SweatyOffenburg/Servo/HardwareMotorcontrollerV1.2/README.md

# Servo
Publication of Sweaty's servo Hardware describede 12th Workshop on Humanoid Soccer Robots IEEE RAS International Conference on Humanoid Robots — November 15-17, 2017, Birmingham (UK)
  /
