SweatyOffenburg/Servo/HardwareMotorcontrollerV1.2/Servo2015_Logic_V1.2.brd.pdf

2.2u150R
100n

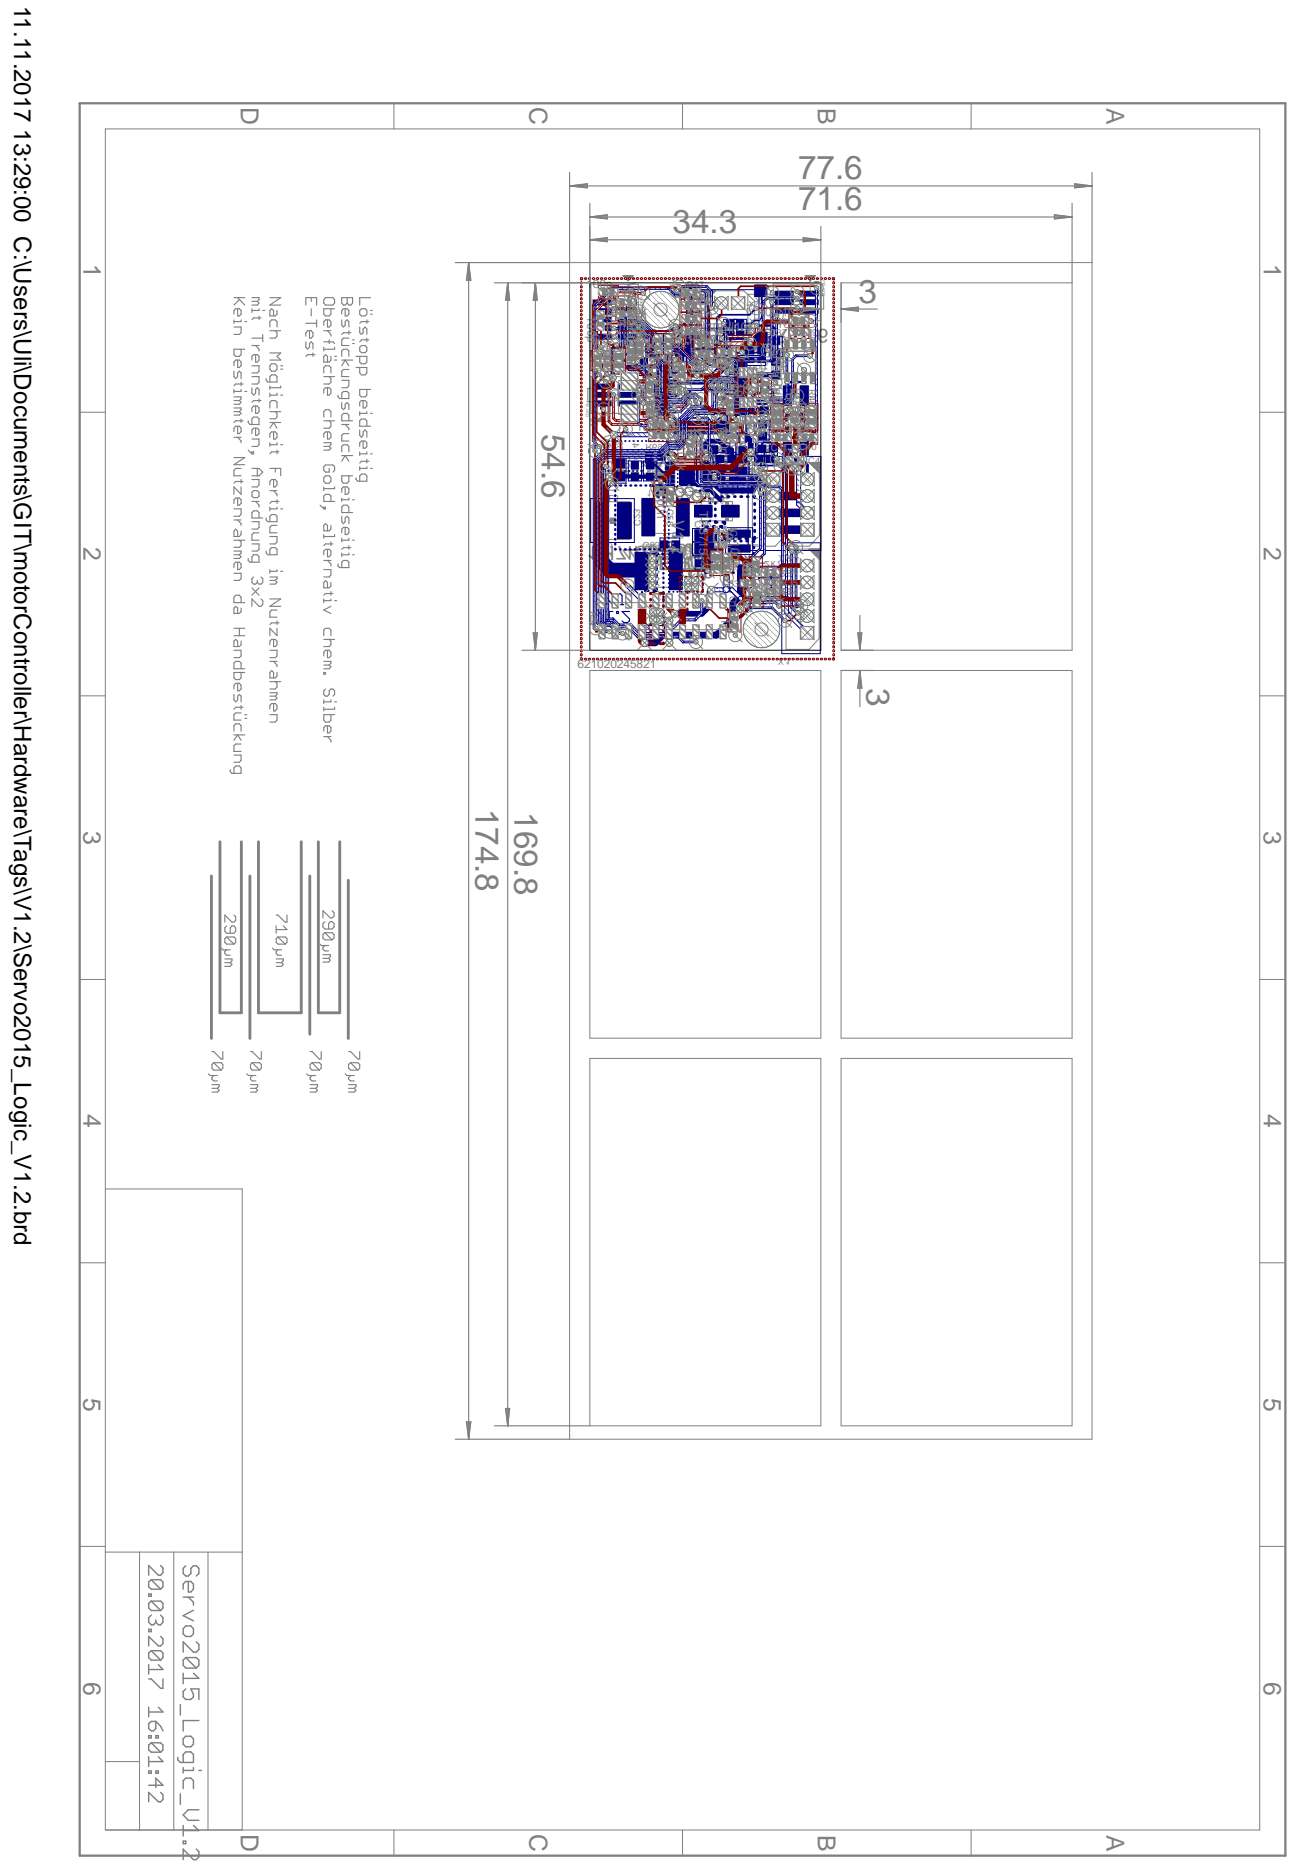
[picture p1: page 1]

11.11.2017 13:29:00 C:\Users\Uli\Documents\GIT\motorController\Hardware\Tags\V1.2\Servo2015_Logic_V1.2.brd
