SweatyOffenburg/Servo/HardwareMotorcontrollerV1.2/Servo2015_Logic_V1.2.sch.pdf

L4

L3

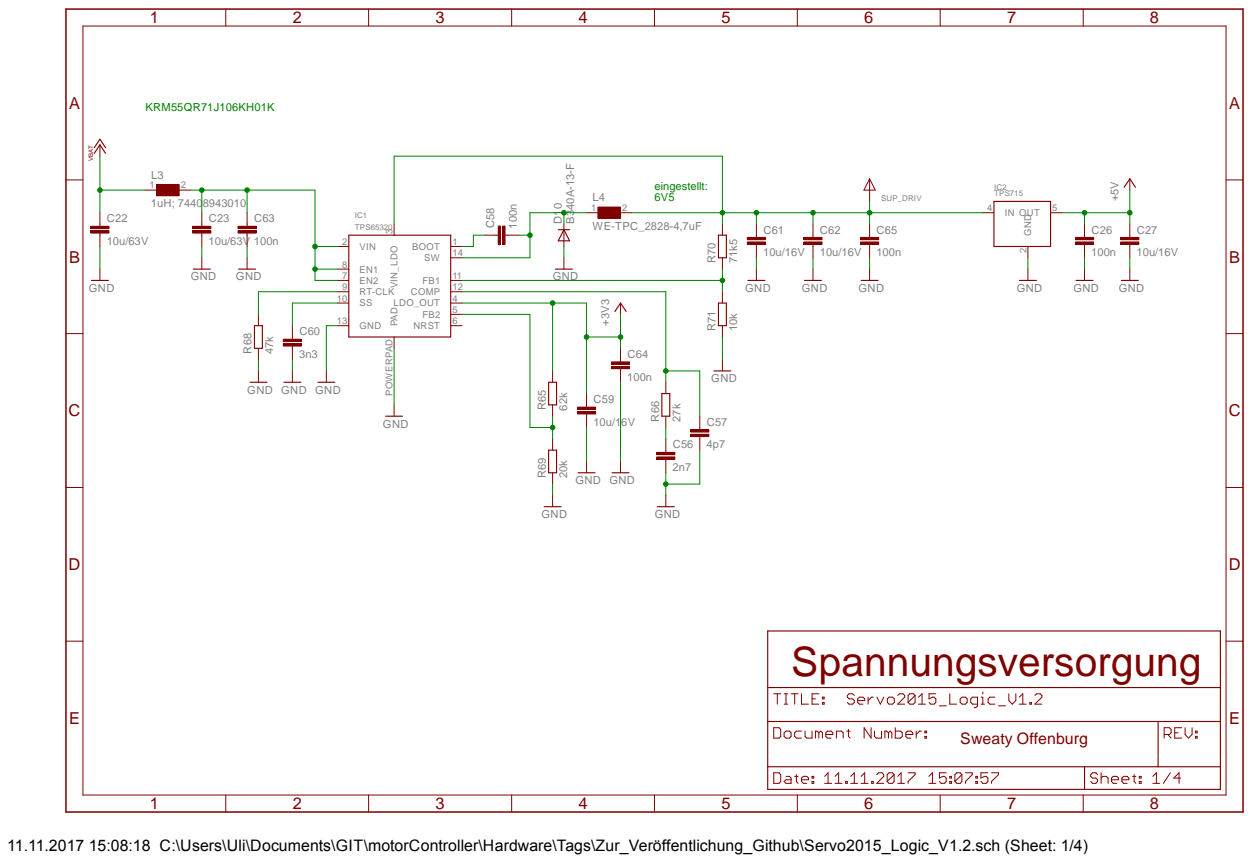
[picture p2: page 1]

11.11.2017 15:08:18 C:\Users\Uli\Documents\GIT\motorController\Hardware\Tags\Zur_Veröffentlichung_Github\Servo2015_Logic_V1.2.sch (Sheet: 1/4)

10k

1n

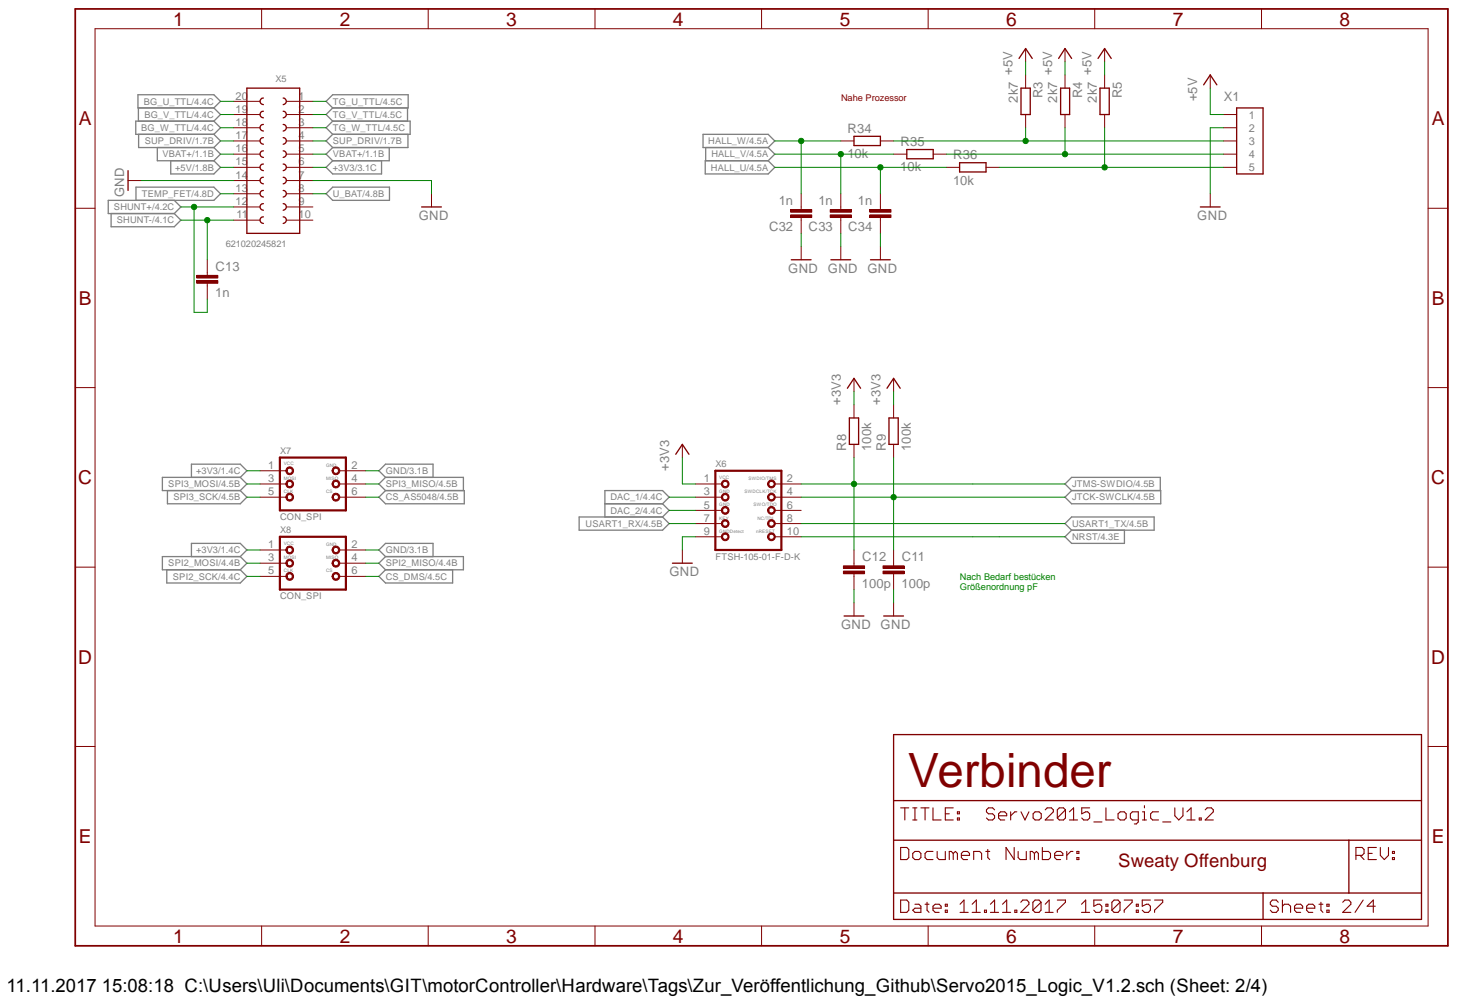
[picture p3: page 2]

11.11.2017 15:08:18 C:\Users\Uli\Documents\GIT\motorController\Hardware\Tags\Zur_Veröffentlichung_Github\Servo2015_Logic_V1.2.sch (Sheet: 2/4)

A

A

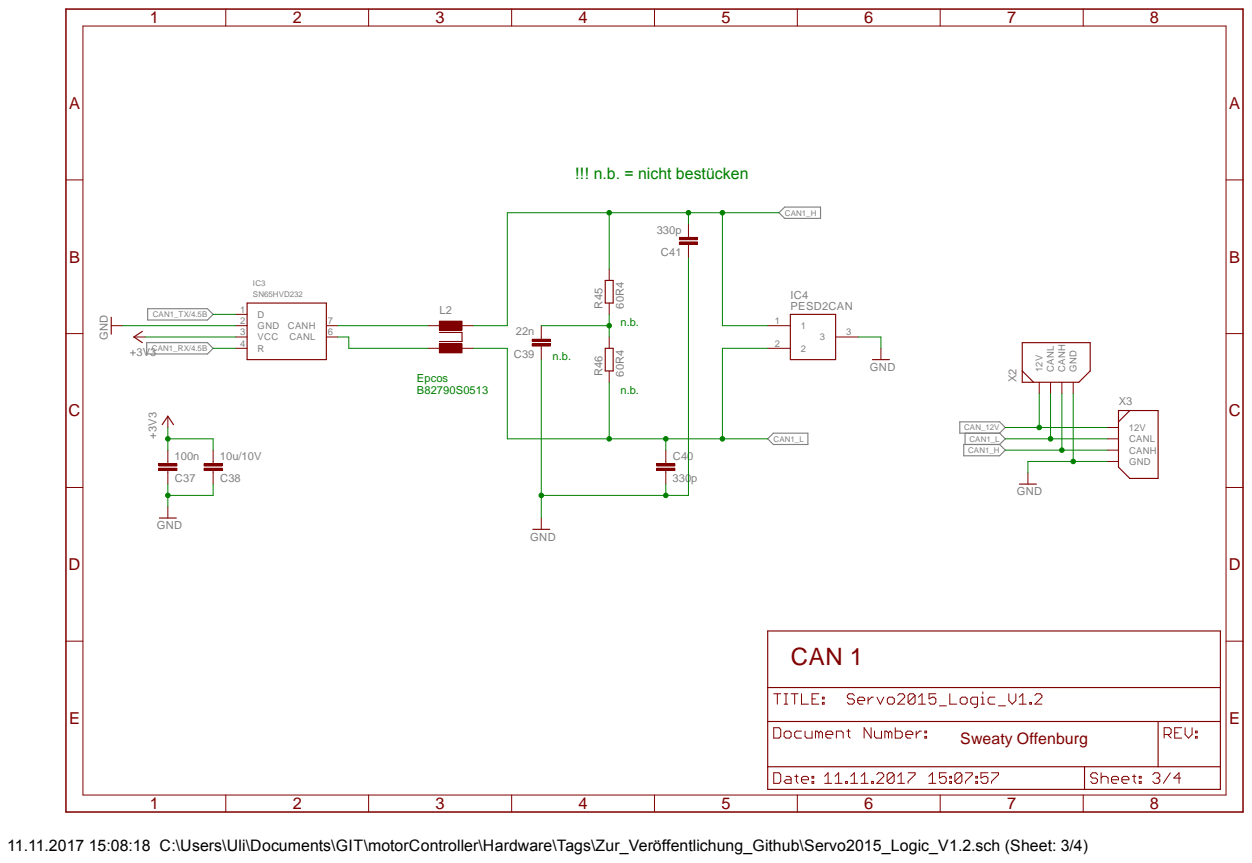
[picture p4: page 3]

11.11.2017 15:08:18 C:\Users\Uli\Documents\GIT\motorController\Hardware\Tags\Zur_Veröffentlichung_Github\Servo2015_Logic_V1.2.sch (Sheet: 3/4)

1u | 100n

WE 742792040

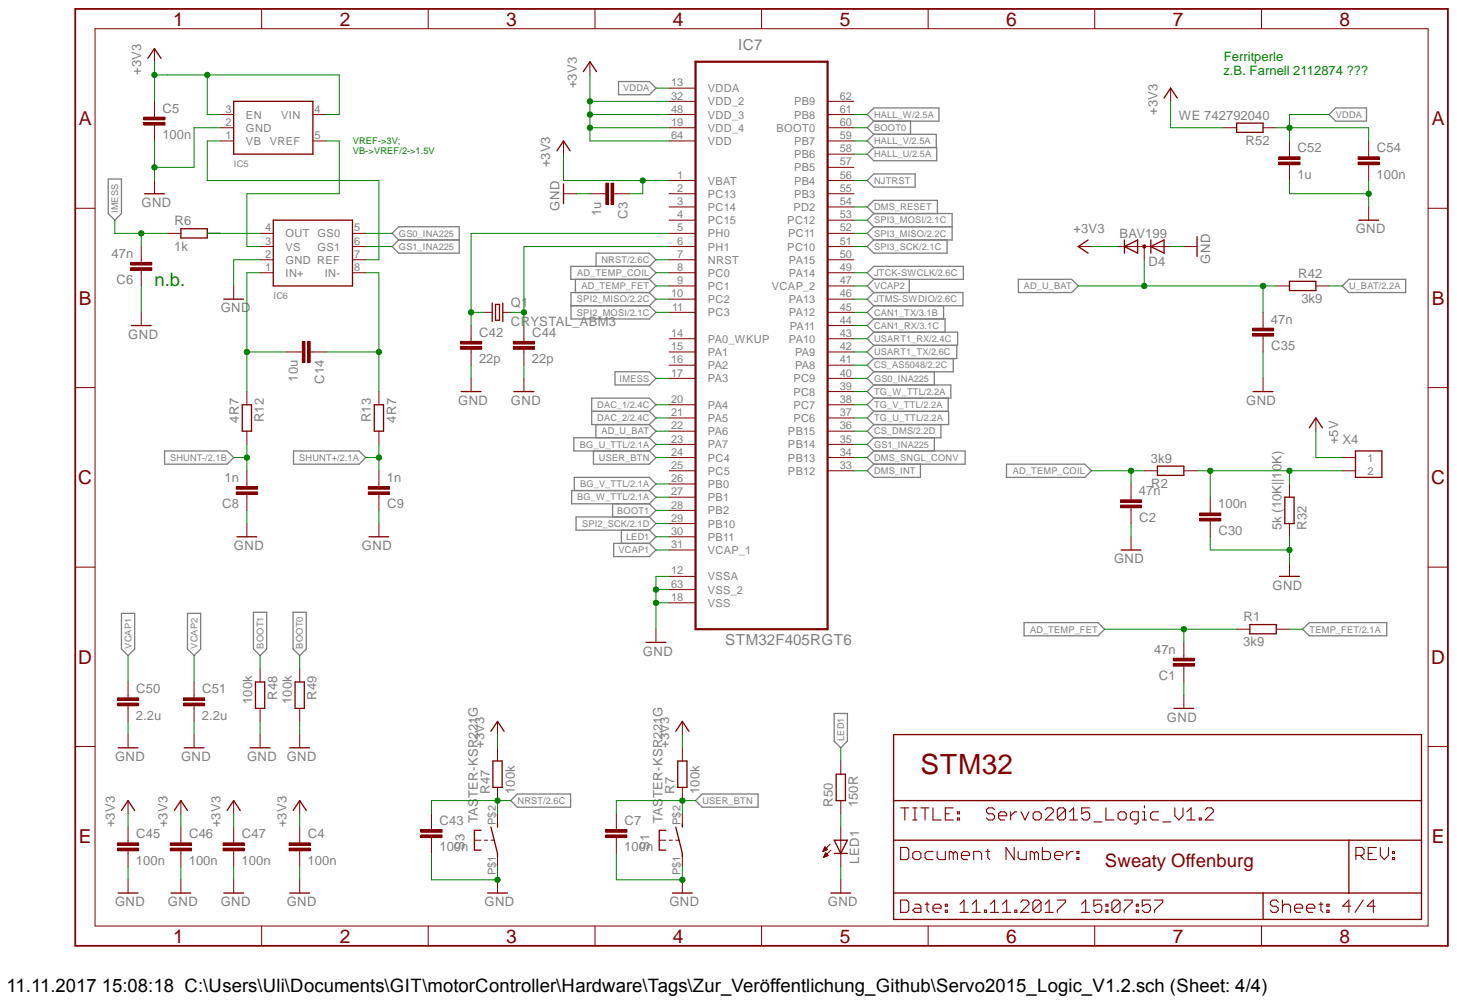
[picture p5: page 4]

11.11.2017 15:08:18 C:\Users\Uli\Documents\GIT\motorController\Hardware\Tags\Zur_Veröffentlichung_Github\Servo2015_Logic_V1.2.sch (Sheet: 4/4)
