SweatyOffenburg/Servo/HardwareMotorcontrollerV1.2/Servo2015_Power_V1.2.brd.pdf

## 10n ¹⁰k

## 10n ¹⁰k

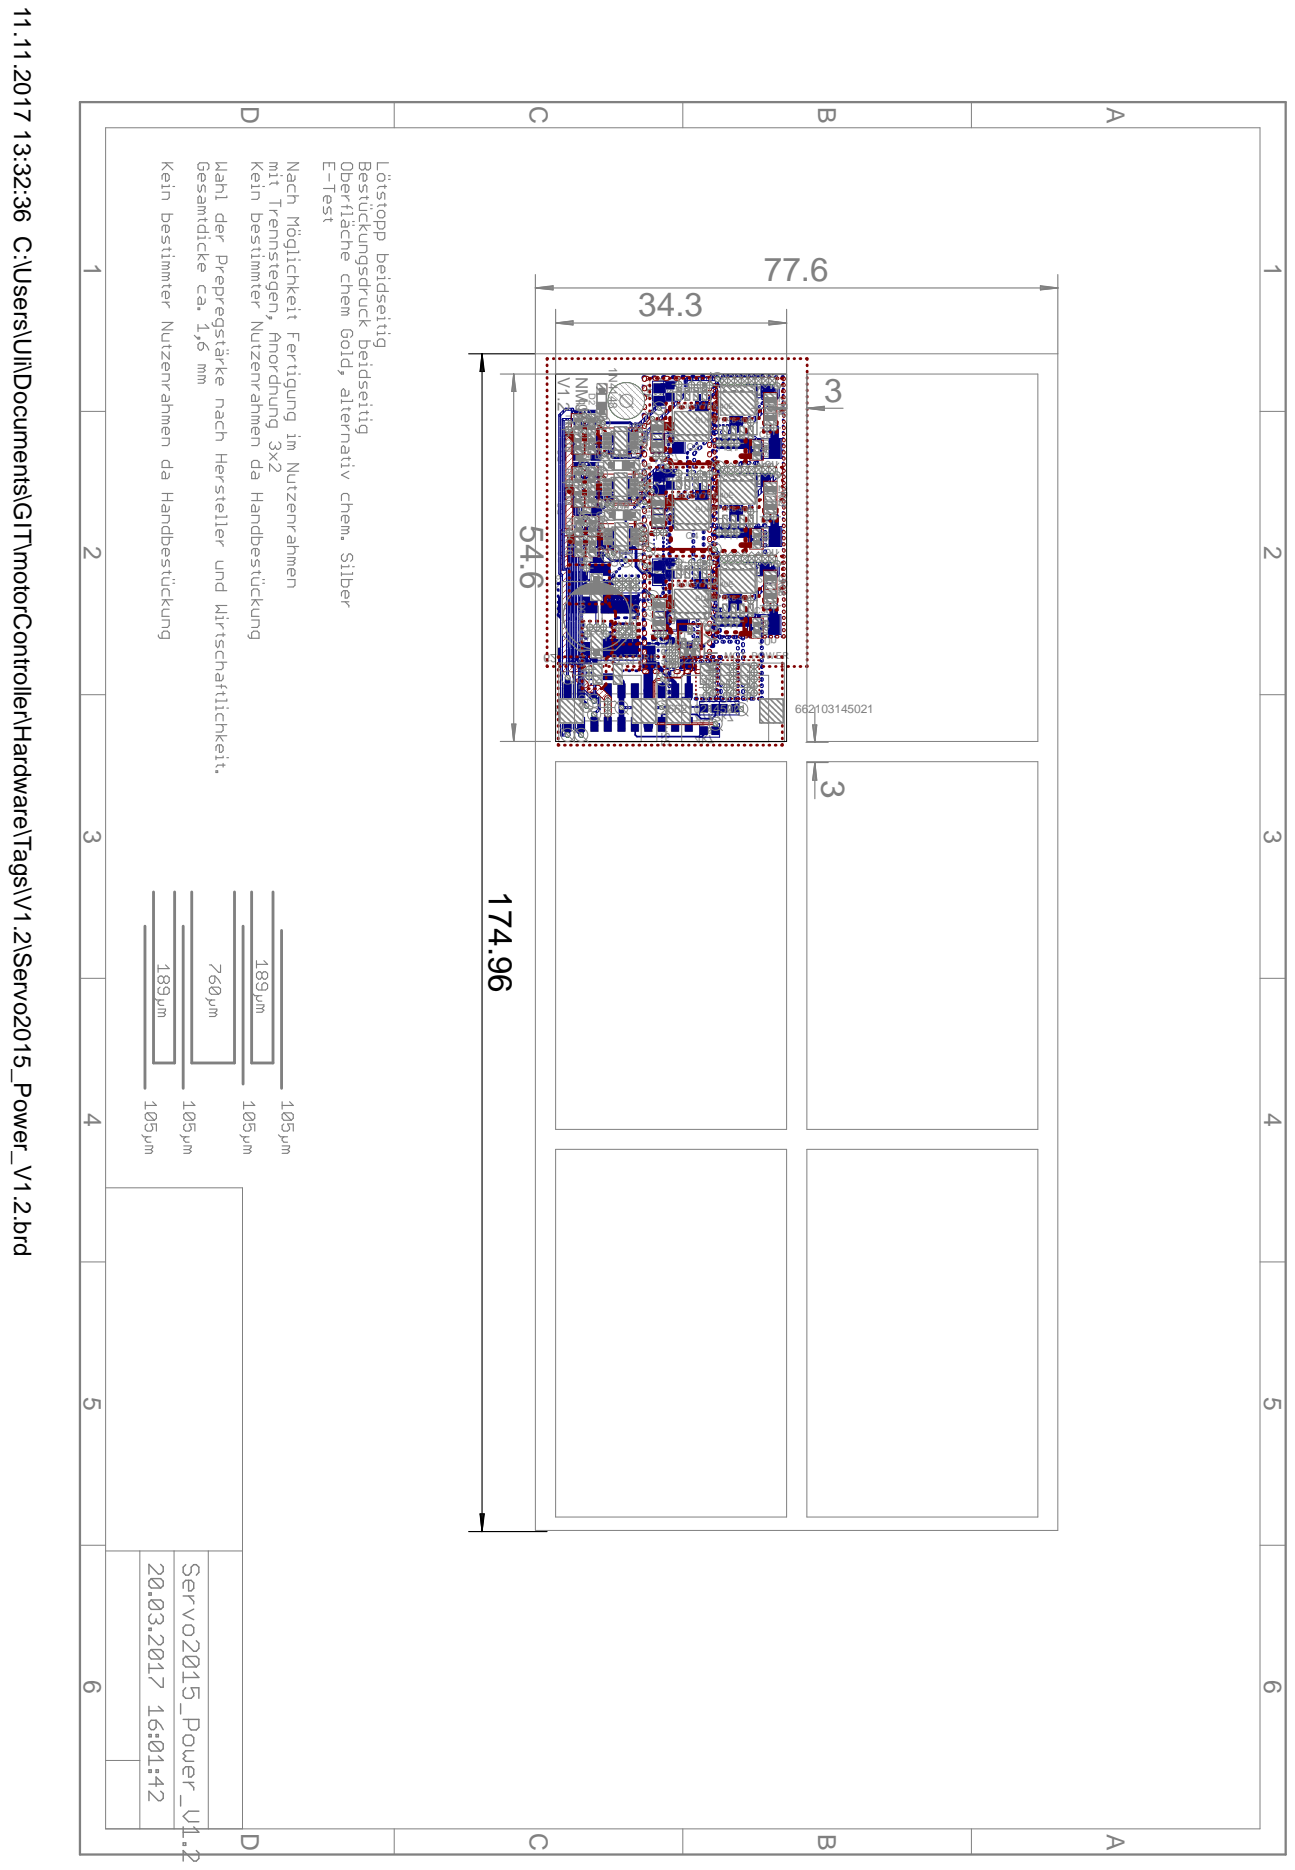
[picture p6: page 1]

11.11.2017 13:32:36 C:\Users\Uli\Documents\GIT\motorController\Hardware\Tags\V1.2\Servo2015_Power_V1.2.brd
