SweatyOffenburg/Servo/HardwareMotorcontrollerV1.2/Servo2015_Power_V1.2.sch.pdf

A

A

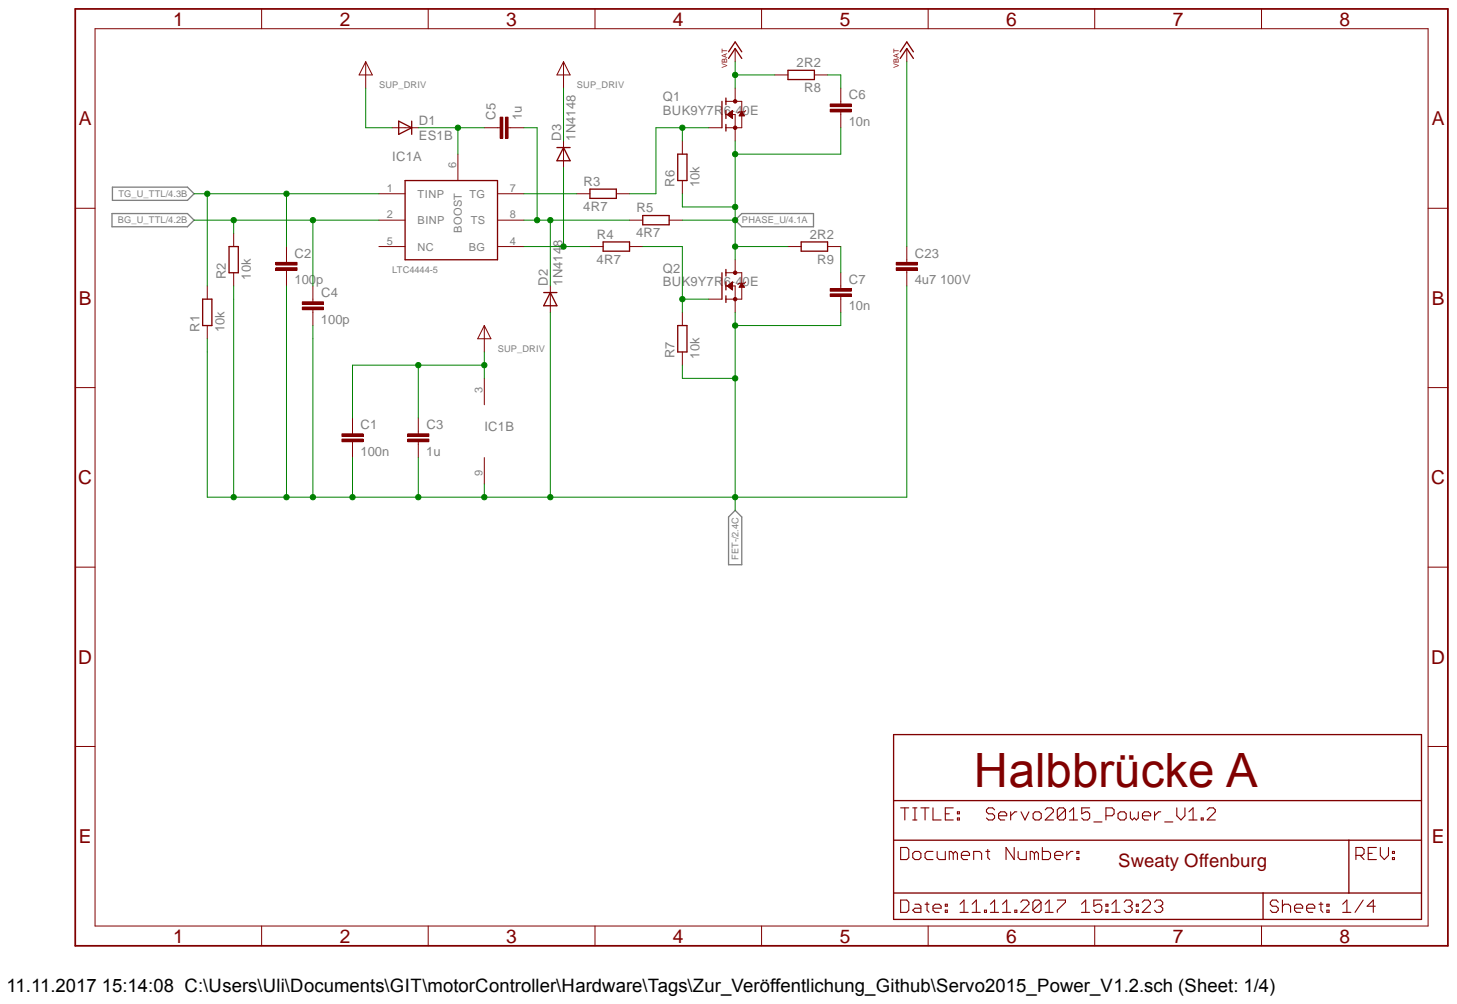
[picture p7: page 1]

11.11.2017 15:14:08 C:\Users\Uli\Documents\GIT\motorController\Hardware\Tags\Zur_Veröffentlichung_Github\Servo2015_Power_V1.2.sch (Sheet: 1/4)

A

A

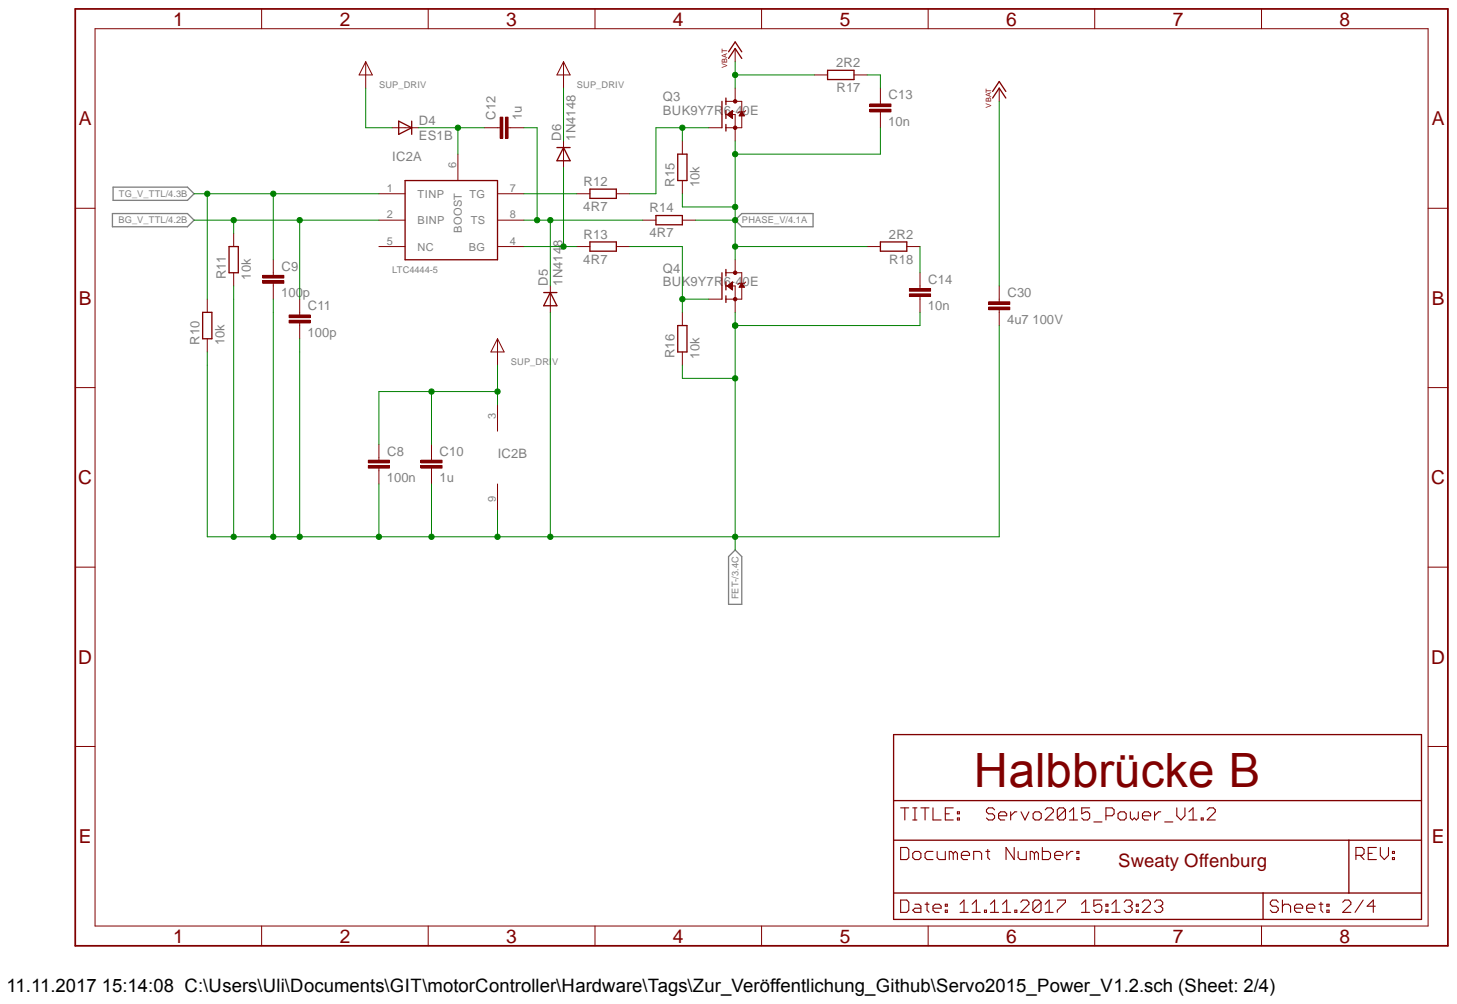
[picture p8: page 2]

11.11.2017 15:14:08 C:\Users\Uli\Documents\GIT\motorController\Hardware\Tags\Zur_Veröffentlichung_Github\Servo2015_Power_V1.2.sch (Sheet: 2/4)

A

A

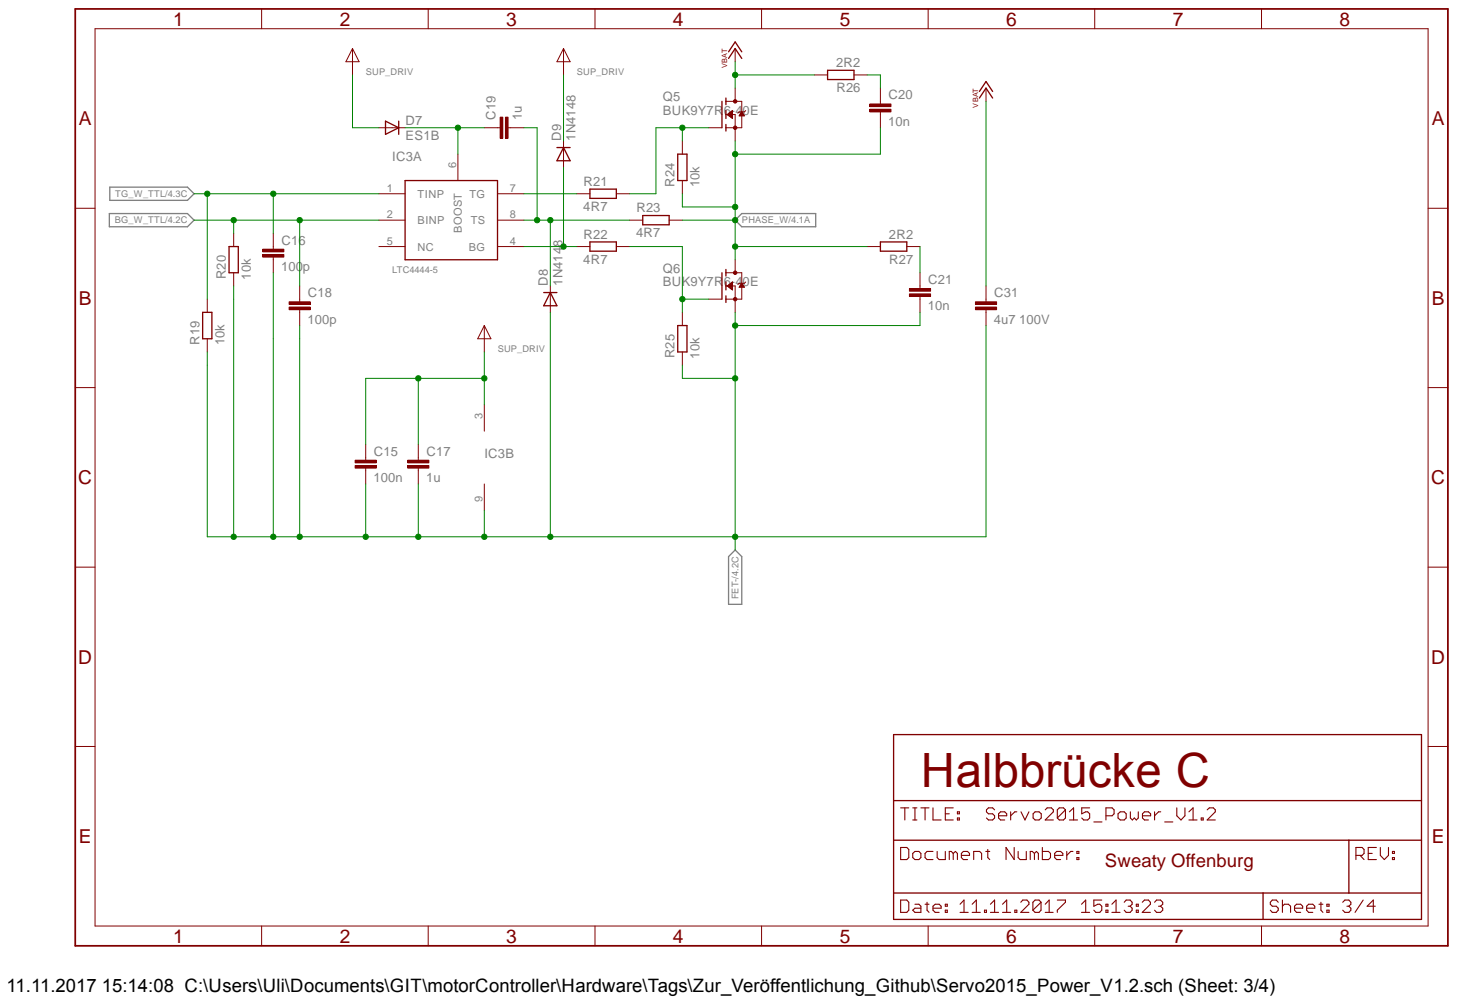
[picture p9: page 3]

11.11.2017 15:14:08 C:\Users\Uli\Documents\GIT\motorController\Hardware\Tags\Zur_Veröffentlichung_Github\Servo2015_Power_V1.2.sch (Sheet: 3/4)

A

A

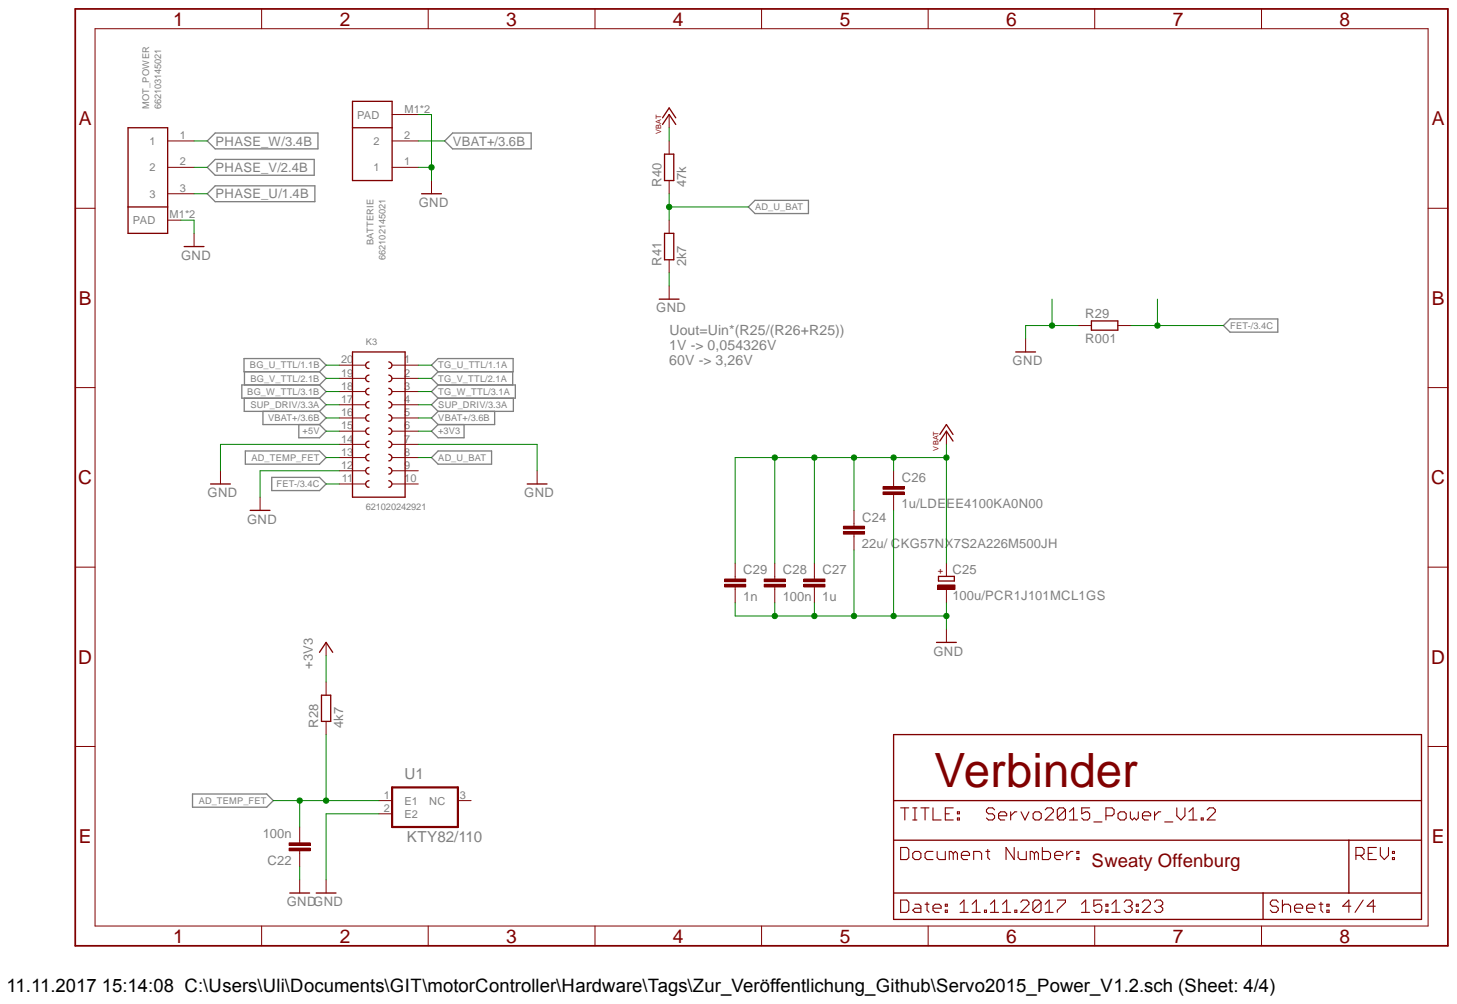
[picture p10: page 4]

11.11.2017 15:14:08 C:\Users\Uli\Documents\GIT\motorController\Hardware\Tags\Zur_Veröffentlichung_Github\Servo2015_Power_V1.2.sch (Sheet: 4/4)
