SweatyOffenburg/Servo/HardwareMotorcontrollerV1.2/Servo2015_Logic_V1.2.brd

## EAGLE design HardwareMotorcontrollerV1.2/Servo2015_Logic_V1.2.brd (2017-11-11)

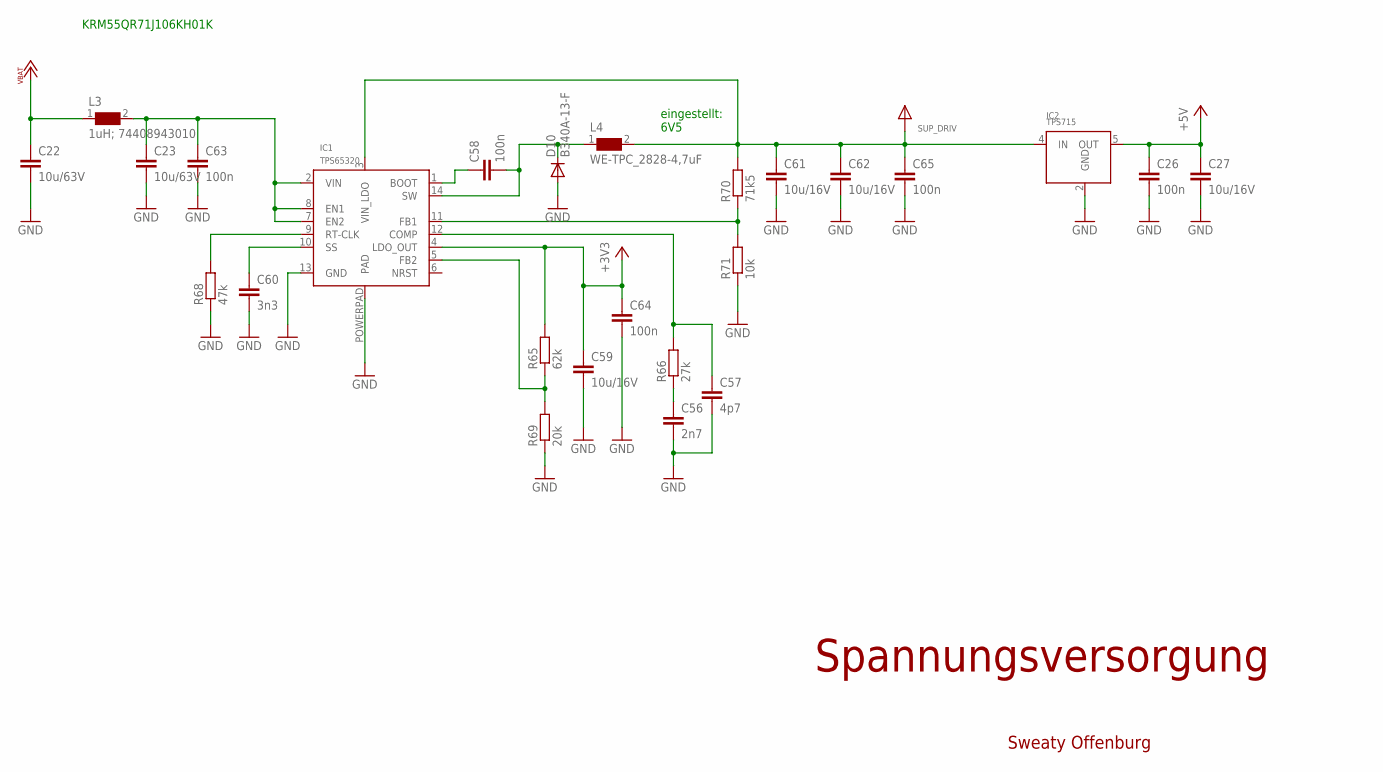
[picture p11: schematic Servo2015_Logic_V1.2.sch, sheet 1, Spannungsversorg]

Parts:
C22, C23: 10u/63V; C2220K
C26, C58, C63, C64, C65: 100n; C0603
C27, C59, C61, C62: 10u/16V; C0805
C56: 2n7; C0603
C57: 4p7; C0603
C60: 3n3; C0603
D10: B340A-13-F; SMA
IC1: TPS65320; R.PDSO.G14_PWP
IC2: TPS715; SC-70_DCK_R_PDSO_G5
L3: 1uH; 74408943010; WE-SPC_48XX
L4: WE-TPC_2828-4,7uF; WE-TPC_2828
R65: 62k; R0603
R66: 27k; R0603
R68: 47k; R0603
R69: 20k; R0603
R70: 71k5; R0603
R71: 10k; R0603

Connections:
+3V3: C59.1, C64.1, IC1.4 (LDO_OUT), R65.2; also elsewhere on the board
+5V: C26.1, C27.1, IC2.5 (OUT); also elsewhere on the board
GND: C22.2, C23.2, C26.2, C27.2, C56.2, C57.2, C59.2, C60.2, C61.2, C62.2, C63.2, C64.2, C65.2, D10.A, IC1.13 (GND), IC1.POWERPAD (PAD), IC2.2 (GND), R68.1, R69.1, R71.1; also elsewhere on the board
unnamed: C57.1, IC1.12 (COMP), R66.2
unnamed: C56.1, R66.1
unnamed: IC1.5 (FB2), R65.1, R69.2
unnamed: C58.2, D10.C, IC1.14 (SW), L4.1
unnamed: IC1.11 (FB1), R70.1, R71.2
unnamed: C60.1, IC1.10 (SS)
unnamed: IC1.9 (RT-CLK), R68.2
unnamed: C23.1, C63.1, IC1.2 (VIN), IC1.7 (EN2), IC1.8 (EN1), L3.2
unnamed: C58.1, IC1.1 (BOOT)
SUP_DRIV: C61.1, C62.1, C65.1, IC1.3 (VIN_LDO), IC2.4 (IN), L4.2, R70.2; also elsewhere on the board
VBAT+: C22.1, L3.1; also elsewhere on the board

Notes on the sheet:
Spannungsversorgung
eingestellt: 6V5
KRM55QR71J106KH01K
Sweaty Offenburg

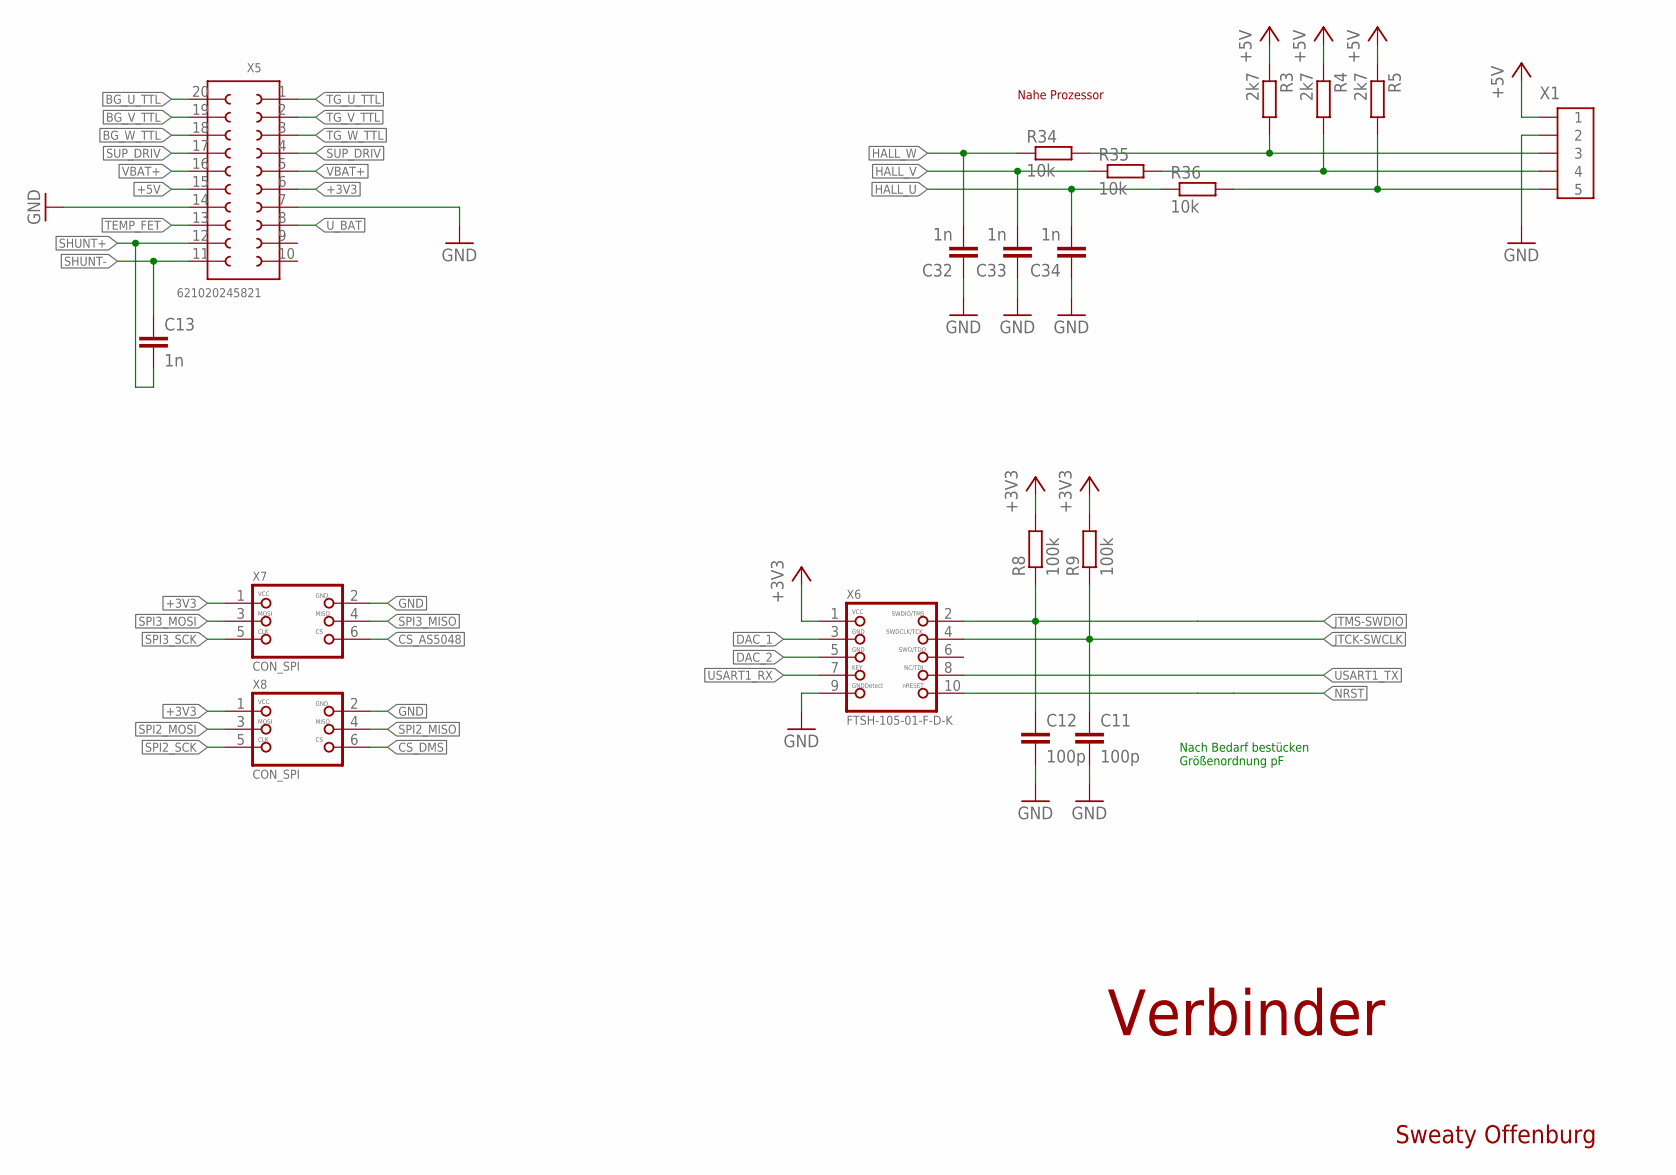
[picture p12: schematic Servo2015_Logic_V1.2.sch, sheet 2]

Parts:
C11, C12: 100p; C0603
C13, C32, C33, C34: 1n; C0603
R3, R4, R5: 2k7; R0603
R8, R9: 100k; R0603
R34, R35, R36: 10k; R0603
X1: HALL-5POL-SERVOBOARD; MOLEX-SPOX-5POL-VERT
X5: 621020245821
X6: FTSH-105-01-F-D-K; 2X05_1.27MM_SMT
X7, X8: CON_SPI; 2X03_1.27MM_SMT

Connections:
+3V3: R8.2, R9.2, X5.6, X6.1, X7.1, X8.1; also elsewhere on the board
+5V: R3.1, R4.1, R5.1, X1.1, X5.15; also elsewhere on the board
BG_U_TTL: X5.20; also elsewhere on the board
BG_V_TTL: X5.19; also elsewhere on the board
BG_W_TTL: X5.18; also elsewhere on the board
CS_AS5048: X7.6; also elsewhere on the board
CS_DMS: X8.6; also elsewhere on the board
DAC_1: X6.3; also elsewhere on the board
DAC_2: X6.5; also elsewhere on the board
GND: C11.2, C12.2, C32.1, C33.1, C34.1, X1.2, X5.7, X5.14, X6.9, X7.2, X8.2; also elsewhere on the board
HALL_U: C34.2, R36.1; also elsewhere on the board
HALL_V: C33.2, R35.1; also elsewhere on the board
HALL_W: C32.2, R34.1; also elsewhere on the board
JTCK-SWCLK: C11.1, R9.1, X6.4; also elsewhere on the board
JTMS-SWDIO: C12.1, R8.1, X6.2; also elsewhere on the board
unnamed: R3.2, R34.2, X1.3
unnamed: R4.2, R35.2, X1.4
unnamed: R5.2, R36.2, X1.5
NRST: X6.10; also elsewhere on the board
SHUNT+: C13.2, X5.12; also elsewhere on the board
SHUNT-: C13.1, X5.11; also elsewhere on the board
SPI2_MISO: X8.4; also elsewhere on the board
SPI2_MOSI: X8.3; also elsewhere on the board
SPI2_SCK: X8.5; also elsewhere on the board
SPI3_MISO: X7.4; also elsewhere on the board
SPI3_MOSI: X7.3; also elsewhere on the board
SPI3_SCK: X7.5; also elsewhere on the board
SUP_DRIV: X5.4, X5.17; also elsewhere on the board
TEMP_FET: X5.13; also elsewhere on the board
TG_U_TTL: X5.1; also elsewhere on the board
TG_V_TTL: X5.2; also elsewhere on the board
TG_W_TTL: X5.3; also elsewhere on the board
USART1_RX: X6.7; also elsewhere on the board
USART1_TX: X6.8; also elsewhere on the board
U_BAT: X5.8; also elsewhere on the board
VBAT+: X5.5, X5.16; also elsewhere on the board

Notes on the sheet:
Verbinder
Nahe Prozessor
Nach Bedarf bestücken Größenordnung pF
Sweaty Offenburg

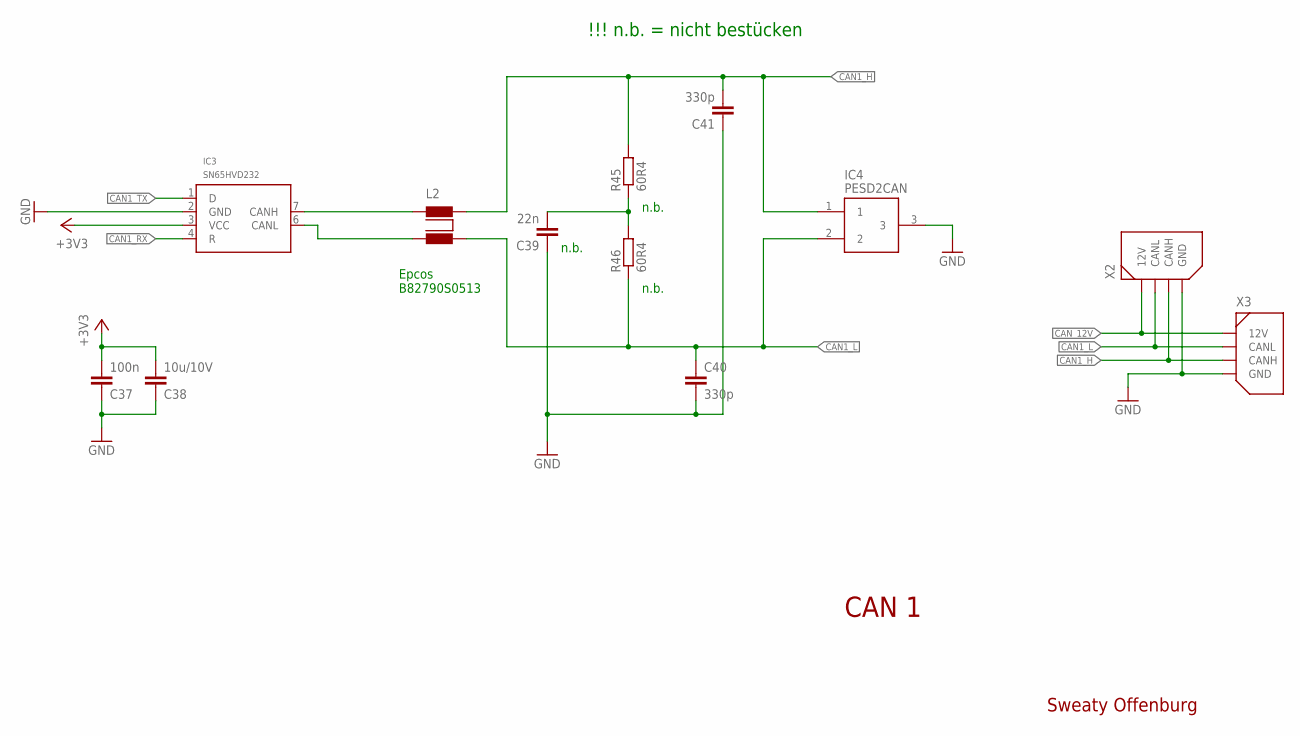
[picture p13: schematic Servo2015_Logic_V1.2.sch, sheet 3, CAN]

Parts:
C37: 100n; C0603
C38: 10u/10V; C0603
C39: 22n; C0603
C40, C41: 330p; C0603
IC3: SN65HVD232; SO-8
IC4: PESD2CAN; SOT-23(TO263AB)
L2: B82790S0513; B82790C0/S0
R45, R46: 60R4; R0805
X2, X3: CAN-4POL; MOLEX-SPOX-4PO

Connections:
+3V3: C37.2, C38.2, IC3.3 (VCC); also elsewhere on the board
CAN1_H: C41.2, IC4.1, L2.2, R45.2, X2.P$3 (CANH), X3.P$3 (CANH)
CAN1_L: C40.1, IC4.2, L2.3, R46.1, X2.P$2 (CANL), X3.P$2 (CANL)
CAN1_RX: IC3.4 (R); also elsewhere on the board
CAN1_TX: IC3.1 (D); also elsewhere on the board
CAN_12V: X2.P$1 (12V), X3.P$1 (12V)
GND: C37.1, C38.1, C39.1, C40.2, C41.1, IC3.2 (GND), IC4.3, X2.P$4 (GND), X3.P$4 (GND); also elsewhere on the board
unnamed: C39.2, R45.1, R46.2
unnamed: IC3.7 (CANH), L2.1
unnamed: IC3.6 (CANL), L2.4

Notes on the sheet:
Epcos B82790S0513
CAN 1
n.b.
!!! n.b. = nicht bestücken
Sweaty Offenburg

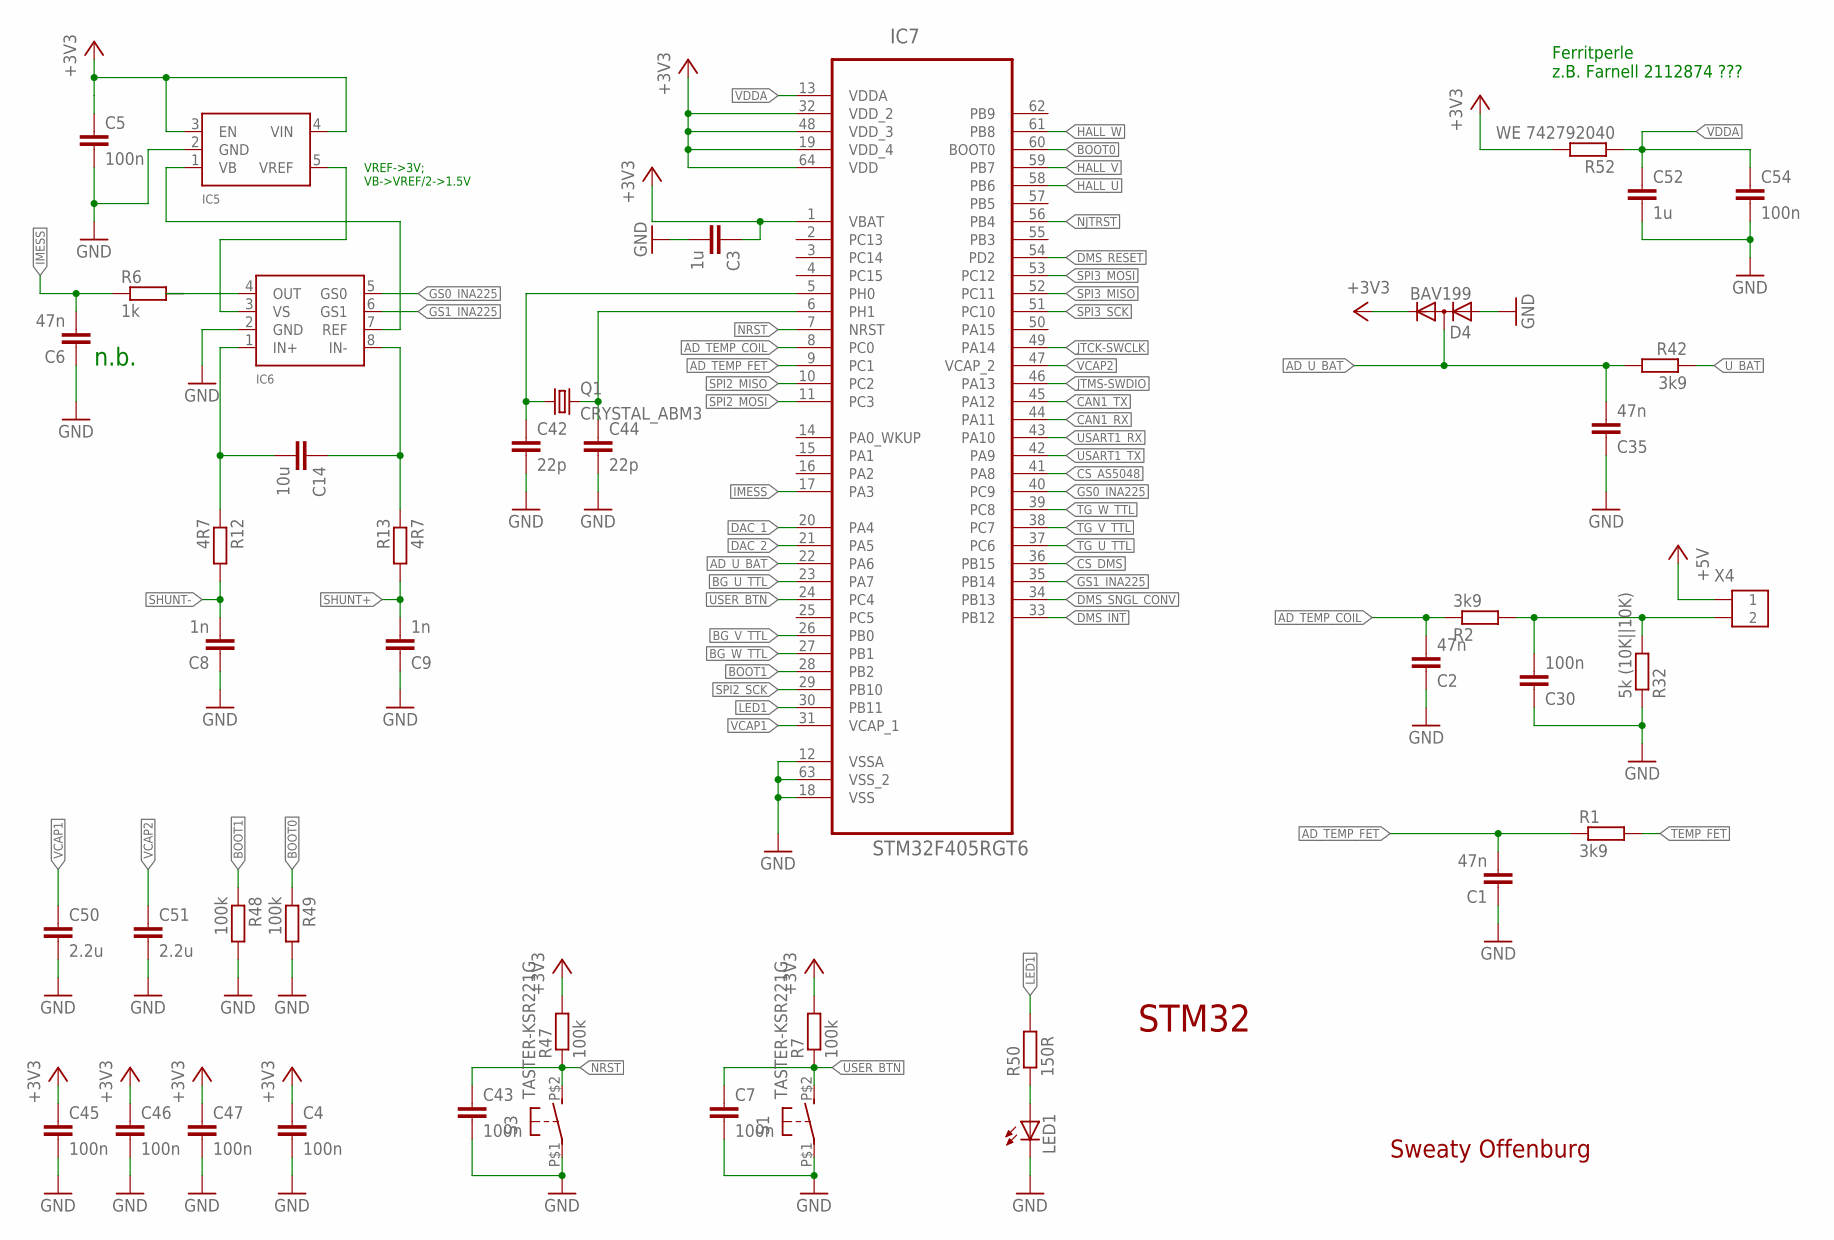
[picture p14: schematic Servo2015_Logic_V1.2.sch, sheet 4]

Parts:
C1, C2, C6, C35: 47n; C0603
C3, C52: 1u; C0603
C4, C5, C7, C30, C43, C45, C46, C47, C54: 100n; C0603
C8, C9: 1n; C0603
C14: 10u; C0603
C42, C44: 22p; C0603
C50, C51: 2.2u; C0603
D4: BAV199; SOT23
IC5: REF2030; R-PDSO-G5
IC6: INA225; S-PDSO-G8
IC7: STM32F405RGT6; QFP50P1200X1200X160-64N
LED1: LEDCHIPLED_0805; CHIPLED_0805
Q1: CRYSTAL_ABM3; CRYSTAL-5X3.2
R1, R2, R42: 3k9; R0603
R6: 1k; R0603
R7, R47, R48, R49: 100k; R0603
R12, R13: 4R7; R0603
R32: 5k (10K||10K); R0603
R50: 150R; R0603
R52: WE 742792040; R0805
S1, S3: TASTER-KSR221G; KSR-TASTER
X4: KRAFTSENSOR-2POL; MOLEX-SPOX-2POL

Connections:
+3V3: C3.1, C4.1, C5.1, C45.1, C46.1, C47.1, D4.2 (C), IC5.3 (EN), IC5.4 (VIN), IC7.1 (VBAT), IC7.19 (VDD_4), IC7.32 (VDD_2), IC7.48 (VDD_3), IC7.64 (VDD), R7.2, R47.2, R52.2; also elsewhere on the board
+5V: X4.P$1 (1); also elsewhere on the board
AD_TEMP_COIL: C2.2, IC7.8 (PC0), R2.1
AD_TEMP_FET: C1.2, IC7.9 (PC1), R1.1
AD_U_BAT: C35.2, D4.3 (AC), IC7.22 (PA6), R42.2
BG_U_TTL: IC7.23 (PA7); also elsewhere on the board
BG_V_TTL: IC7.26 (PB0); also elsewhere on the board
BG_W_TTL: IC7.27 (PB1); also elsewhere on the board
BOOT0: IC7.60 (BOOT0), R49.1
BOOT1: IC7.28 (PB2), R48.1
CAN1_RX: IC7.44 (PA11); also elsewhere on the board
CAN1_TX: IC7.45 (PA12); also elsewhere on the board
CS_AS5048: IC7.41 (PA8); also elsewhere on the board
CS_DMS: IC7.36 (PB15); also elsewhere on the board
DAC_1: IC7.20 (PA4); also elsewhere on the board
DAC_2: IC7.21 (PA5); also elsewhere on the board
DMS_INT: IC7.33 (PB12)
DMS_RESET: IC7.54 (PD2)
DMS_SNGL_CONV: IC7.34 (PB13)
GND: C1.1, C2.1, C3.2, C4.2, C5.2, C6.1, C7.2, C8.1, C9.1, C30.1, C35.1, C42.2, C43.2, C44.2, C45.2, C46.2, C47.2, C50.2, C51.2, C52.2, C54.2, D4.1 (A), IC5.2 (GND), IC6.2 (GND), IC7.12 (VSSA), IC7.18 (VSS), IC7.63 (VSS_2), LED1.C, R32.1, R48.2, R49.2, S1.P$1, S3.P$1; also elsewhere on the board
GS0_INA225: IC6.5 (GS0), IC7.40 (PC9)
GS1_INA225: IC6.6 (GS1), IC7.35 (PB14)
HALL_U: IC7.58 (PB6); also elsewhere on the board
HALL_V: IC7.59 (PB7); also elsewhere on the board
HALL_W: IC7.61 (PB8); also elsewhere on the board
IC6: C14.2, IC6.1 (IN+), R12.1
IMESS: C6.2, IC7.17 (PA3), R6.1
JTCK-SWCLK: IC7.49 (PA14); also elsewhere on the board
JTMS-SWDIO: IC7.46 (PA13); also elsewhere on the board
LED1: IC7.30 (PB11), R50.2
unnamed: C14.1, IC6.8 (IN-), R13.1
unnamed: LED1.A, R50.1
unnamed: IC6.4 (OUT), R6.2
unnamed: IC5.5 (VREF), IC6.3 (VS)
unnamed: IC5.1 (VB), IC6.7 (REF)
unnamed: C44.1, IC7.6 (PH1), Q1.P$2 (2)
unnamed: C42.1, IC7.5 (PH0), Q1.P$1 (1)
NJTRST: IC7.56 (PB4)
NRST: C43.1, IC7.7 (NRST), R47.1, S3.P$2 (S); also elsewhere on the board
SHUNT+: C9.2, R13.2; also elsewhere on the board
SHUNT-: C8.2, R12.2; also elsewhere on the board
SPI2_MISO: IC7.10 (PC2); also elsewhere on the board
SPI2_MOSI: IC7.11 (PC3); also elsewhere on the board
SPI2_SCK: IC7.29 (PB10); also elsewhere on the board
SPI3_MISO: IC7.52 (PC11); also elsewhere on the board
SPI3_MOSI: IC7.53 (PC12); also elsewhere on the board
SPI3_SCK: IC7.51 (PC10); also elsewhere on the board
TEMP_COIL: C30.2, R2.2, R32.2, X4.P$2 (2)
TEMP_FET: R1.2; also elsewhere on the board
TG_U_TTL: IC7.37 (PC6); also elsewhere on the board
TG_V_TTL: IC7.38 (PC7); also elsewhere on the board
TG_W_TTL: IC7.39 (PC8); also elsewhere on the board
USART1_RX: IC7.43 (PA10); also elsewhere on the board
USART1_TX: IC7.42 (PA9); also elsewhere on the board
USER_BTN: C7.1, IC7.24 (PC4), R7.1, S1.P$2 (S)
U_BAT: R42.1; also elsewhere on the board
VCAP1: C50.1, IC7.31 (VCAP_1)
VCAP2: C51.1, IC7.47 (VCAP_2)
VDDA: C52.1, C54.1, IC7.13 (VDDA), R52.1

Notes on the sheet:
Ferritperle z.B. Farnell 2112874 ???
STM32
VREF->3V; VB->VREF/2->1.5V
n.b.
Sweaty Offenburg

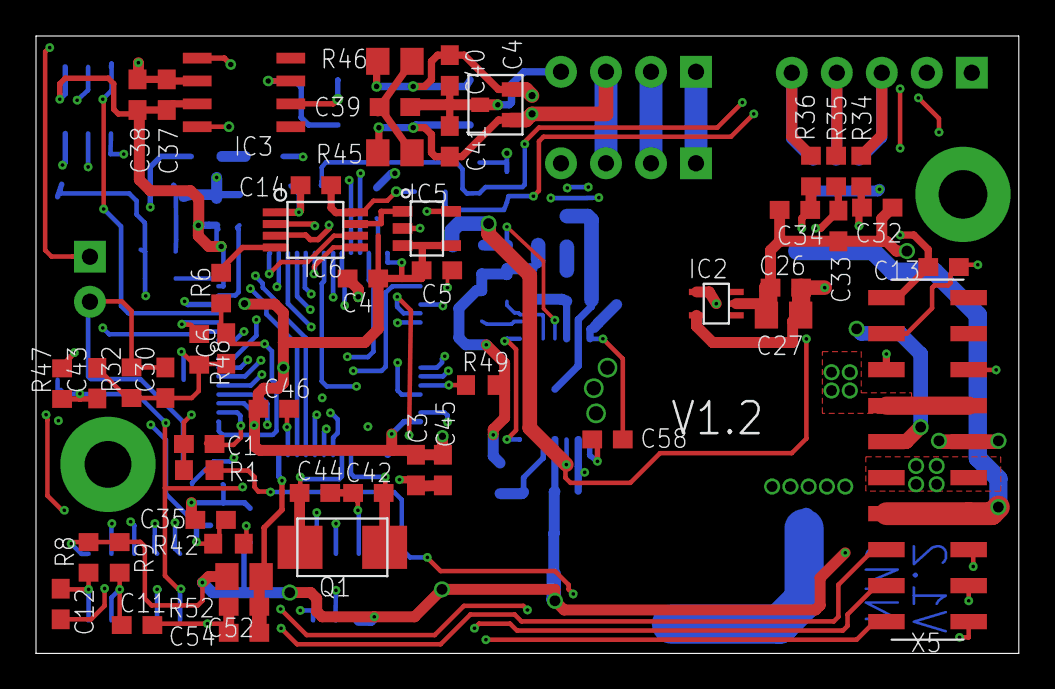
[picture p15: board Servo2015_Logic_V1.2.brd from above]

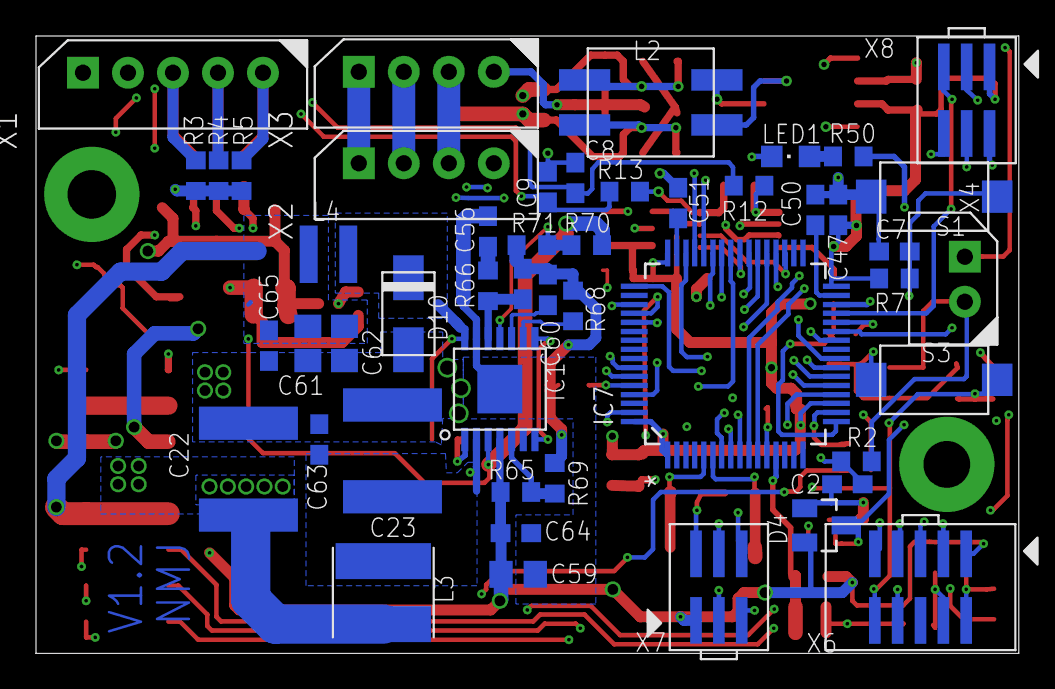
[picture p16: board Servo2015_Logic_V1.2.brd from below]

Board: 4 copper layers, 54.6 x 34.3 mm, 101 parts (49 on the bottom side), 75 nets.

Other parts of the board:
U$1: A4L-LOC
