SweatyOffenburg/Servo/HardwareMotorcontrollerV1.2/Servo2015_Power_V1.2.brd

## EAGLE design HardwareMotorcontrollerV1.2/Servo2015_Power_V1.2.brd (2017-11-11)

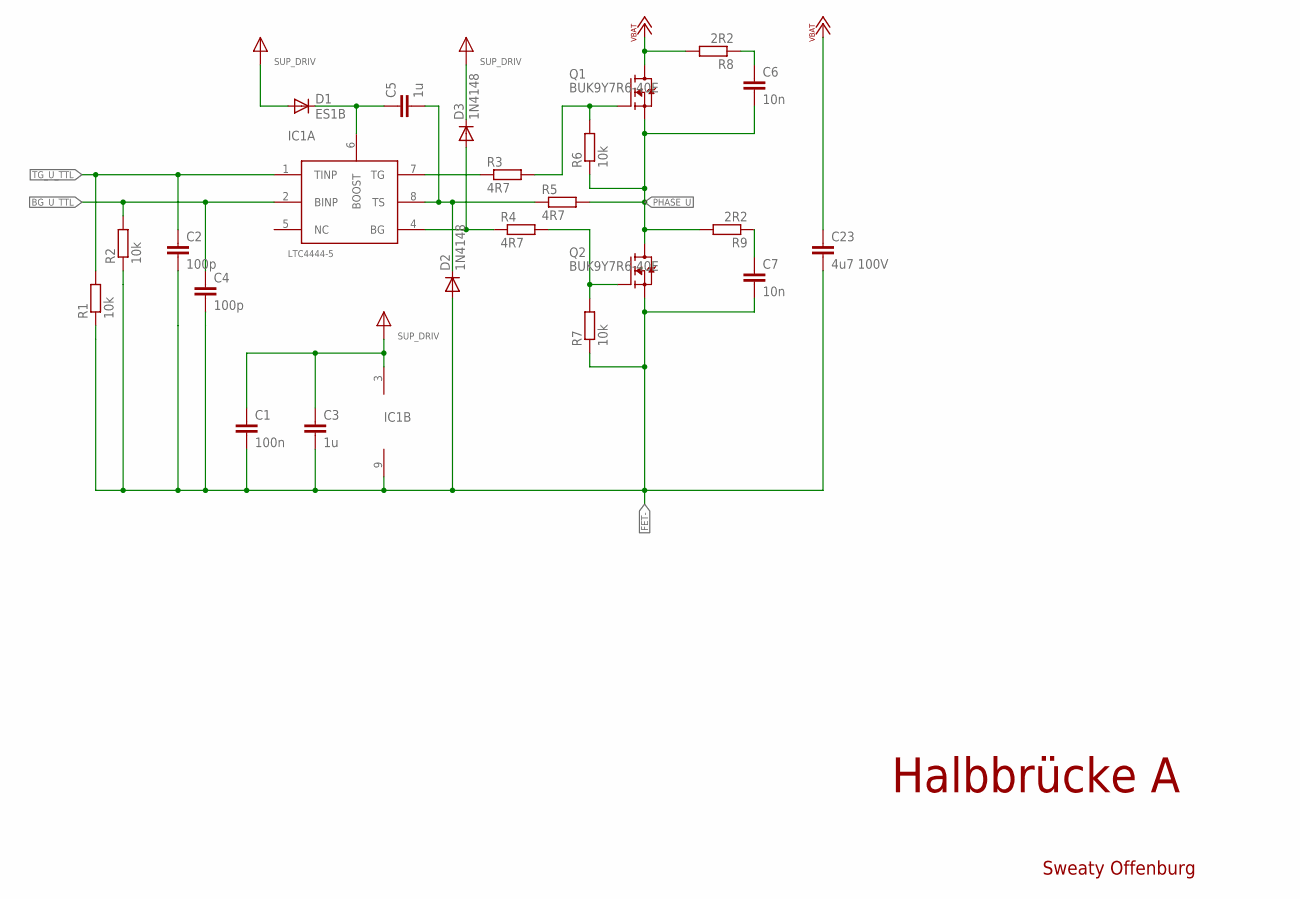
[picture p17: schematic Servo2015_Power_V1.2.sch, sheet 1]

Parts:
C1: 100n; C0603
C2, C4: 100p; C0603
C3, C5: 1u; C0603
C6, C7: 10n; C1210
C23: 4u7 100V; C2220K
D1: ES1B; DO214AC
D2, D3: 1N4148; SOD123
IC1: LTC4444-5; MS8E
Q1, Q2: BUK9Y7R6-40E; LFPAK56
R1, R2, R6, R7: 10k; R0603
R3, R4, R5: 4R7; R0805
R8, R9: 2R2; R1206

Connections:
BGR_A: Q2.4 (G), R4.2, R7.2
BG_U_TTL: C4.1, IC1.2 (BINP), R2.2; also elsewhere on the board
FET-: C1.2, C2.2, C3.2, C4.2, C7.2, C23.2, D2.A, IC1.9 (GND), Q2.1 (S), Q2.2 (S), Q2.3 (S), R1.1, R2.1, R7.1; also elsewhere on the board
unnamed: IC1.7 (TG), R3.1
unnamed: C5.2, D2.C, IC1.8 (TS), R5.1
unnamed: D3.A, IC1.4 (BG), R4.1
unnamed: C5.1, D1.C, IC1.6 (BOOST)
unnamed: C6.1, R8.1
unnamed: C7.1, R9.1
PHASE_U: C6.2, Q1.1 (S), Q1.2 (S), Q1.3 (S), Q2.5-8 (D), R5.2, R6.1, R9.2; also elsewhere on the board
SUP_DRIV: C1.1, C3.1, D1.A, D3.C, IC1.3 (VCC); also elsewhere on the board
TGR_A: Q1.4 (G), R3.2, R6.2
TG_U_TTL: C2.1, IC1.1 (TINP), R1.2; also elsewhere on the board
VBAT+: C23.1, Q1.5-8 (D), R8.2; also elsewhere on the board

Notes on the sheet:
Halbbrücke A
Sweaty Offenburg

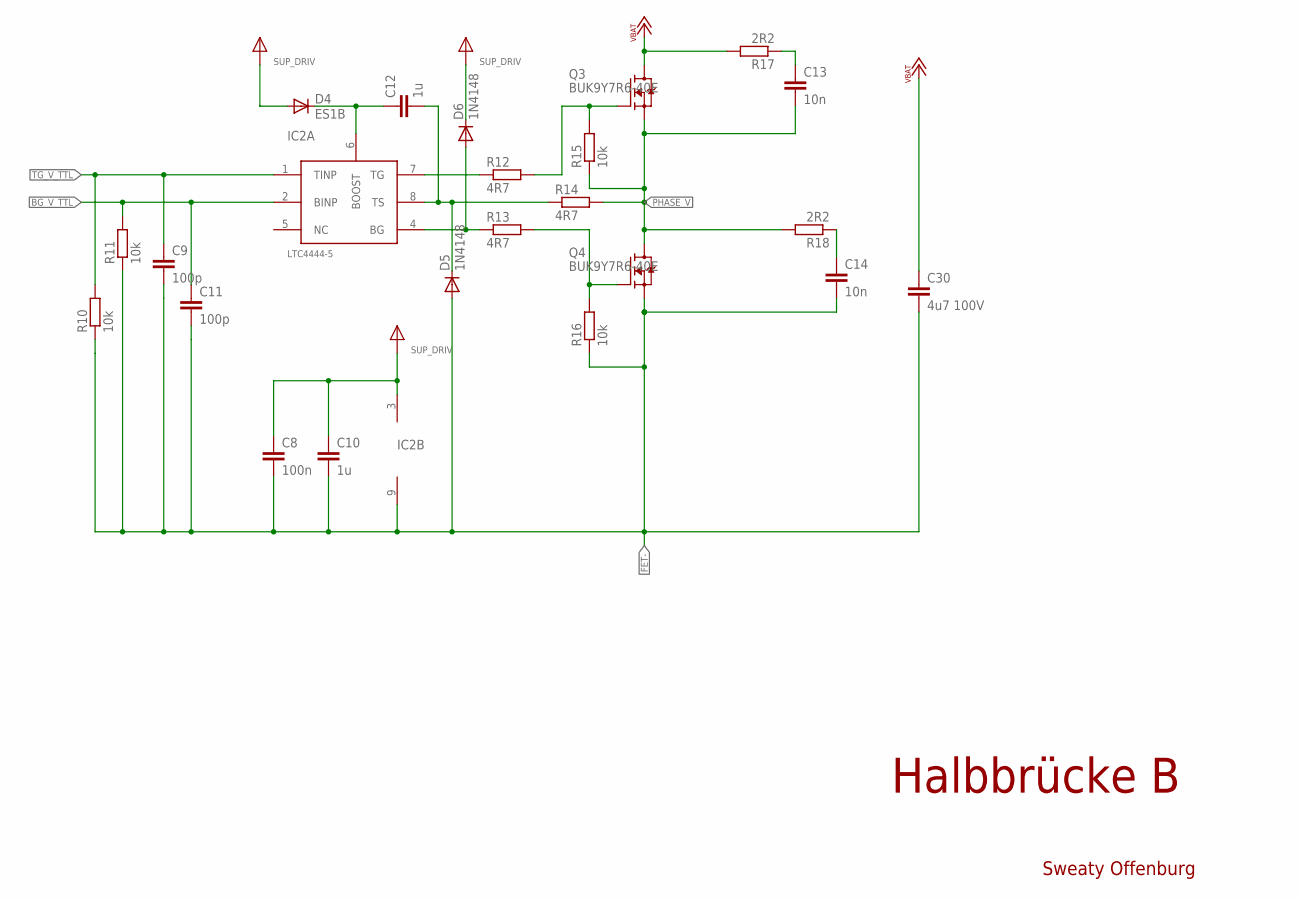
[picture p18: schematic Servo2015_Power_V1.2.sch, sheet 2]

Parts:
C8: 100n; C0603
C9, C11: 100p; C0603
C10, C12: 1u; C0603
C13, C14: 10n; C1210
C30: 4u7 100V; C2220K
D4: ES1B; DO214AC
D5, D6: 1N4148; SOD123
IC2: LTC4444-5; MS8E
Q3, Q4: BUK9Y7R6-40E; LFPAK56
R10, R11, R15, R16: 10k; R0603
R12, R13, R14: 4R7; R0805
R17, R18: 2R2; R1206

Connections:
BGR_B: Q4.4 (G), R13.2, R16.2
BG_V_TTL: C11.1, IC2.2 (BINP), R11.2; also elsewhere on the board
FET-: C8.2, C9.2, C10.2, C11.2, C14.2, C30.2, D5.A, IC2.9 (GND), Q4.1 (S), Q4.2 (S), Q4.3 (S), R10.1, R11.1, R16.1; also elsewhere on the board
unnamed: IC2.7 (TG), R12.1
unnamed: C12.2, D5.C, IC2.8 (TS), R14.1
unnamed: D6.A, IC2.4 (BG), R13.1
unnamed: C12.1, D4.C, IC2.6 (BOOST)
unnamed: C13.1, R17.1
unnamed: C14.1, R18.1
PHASE_V: C13.2, Q3.1 (S), Q3.2 (S), Q3.3 (S), Q4.5-8 (D), R14.2, R15.1, R18.2; also elsewhere on the board
SUP_DRIV: C8.1, C10.1, D4.A, D6.C, IC2.3 (VCC); also elsewhere on the board
TGR_B: Q3.4 (G), R12.2, R15.2
TG_V_TTL: C9.1, IC2.1 (TINP), R10.2; also elsewhere on the board
VBAT+: C30.1, Q3.5-8 (D), R17.2; also elsewhere on the board

Notes on the sheet:
Halbbrücke B
Sweaty Offenburg

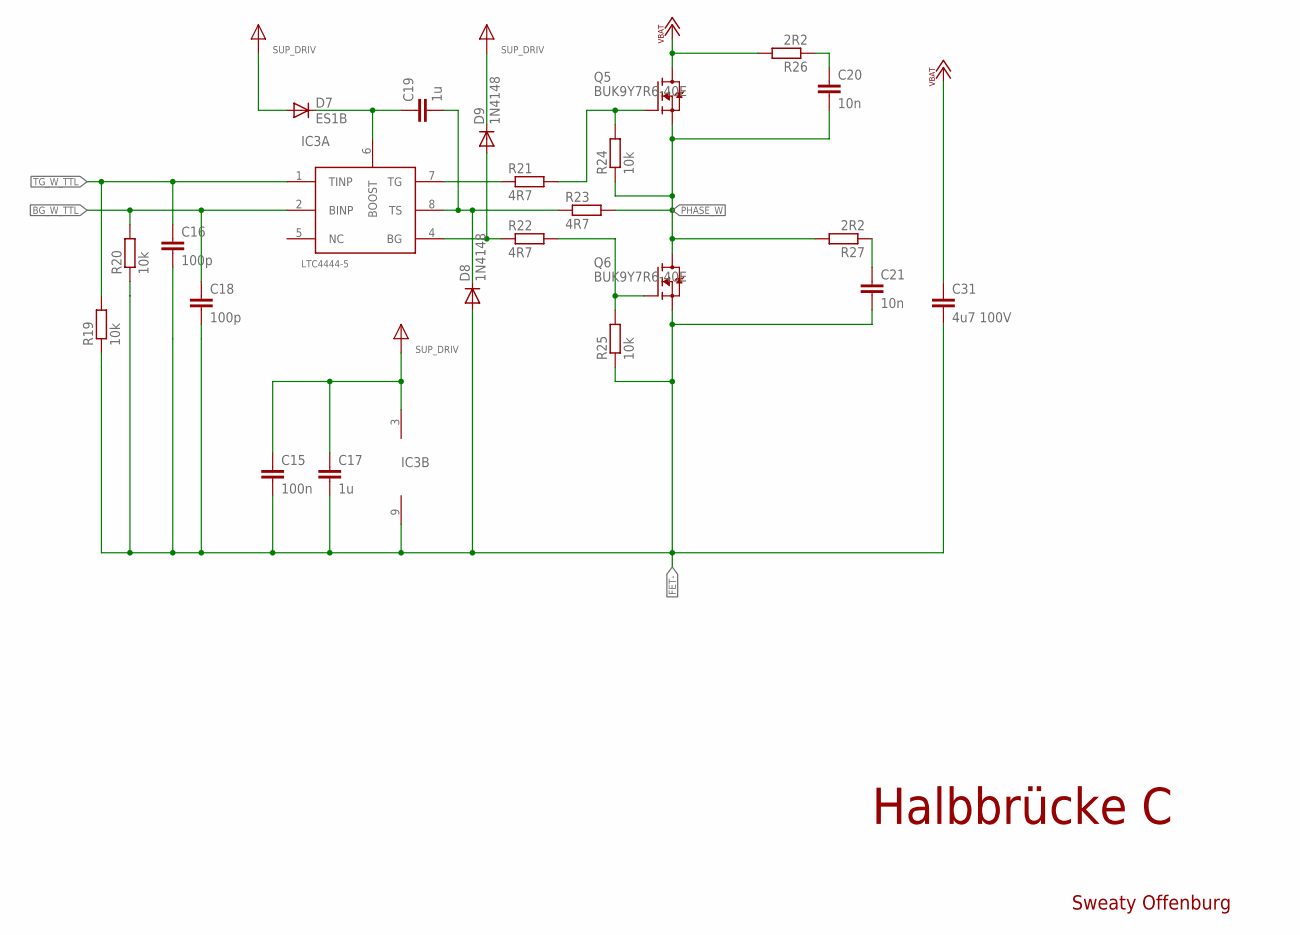
[picture p19: schematic Servo2015_Power_V1.2.sch, sheet 3]

Parts:
C15: 100n; C0603
C16, C18: 100p; C0603
C17, C19: 1u; C0603
C20, C21: 10n; C1210
C31: 4u7 100V; C2220K
D7: ES1B; DO214AC
D8, D9: 1N4148; SOD123
IC3: LTC4444-5; MS8E
Q5, Q6: BUK9Y7R6-40E; LFPAK56
R19, R20, R24, R25: 10k; R0603
R21, R22, R23: 4R7; R0805
R26, R27: 2R2; R1206

Connections:
BGR_C: Q6.4 (G), R22.2, R25.2
BG_W_TTL: C18.1, IC3.2 (BINP), R20.2; also elsewhere on the board
FET-: C15.2, C16.2, C17.2, C18.2, C21.2, C31.2, D8.A, IC3.9 (GND), Q6.1 (S), Q6.2 (S), Q6.3 (S), R19.1, R20.1, R25.1; also elsewhere on the board
unnamed: IC3.7 (TG), R21.1
unnamed: C19.2, D8.C, IC3.8 (TS), R23.1
unnamed: D9.A, IC3.4 (BG), R22.1
unnamed: C19.1, D7.C, IC3.6 (BOOST)
unnamed: C20.1, R26.1
unnamed: C21.1, R27.1
PHASE_W: C20.2, Q5.1 (S), Q5.2 (S), Q5.3 (S), Q6.5-8 (D), R23.2, R24.1, R27.2; also elsewhere on the board
SUP_DRIV: C15.1, C17.1, D7.A, D9.C, IC3.3 (VCC); also elsewhere on the board
TGR_C: Q5.4 (G), R21.2, R24.2
TG_W_TTL: C16.1, IC3.1 (TINP), R19.2; also elsewhere on the board
VBAT+: C31.1, Q5.5-8 (D), R26.2; also elsewhere on the board

Notes on the sheet:
Halbbrücke C
Sweaty Offenburg

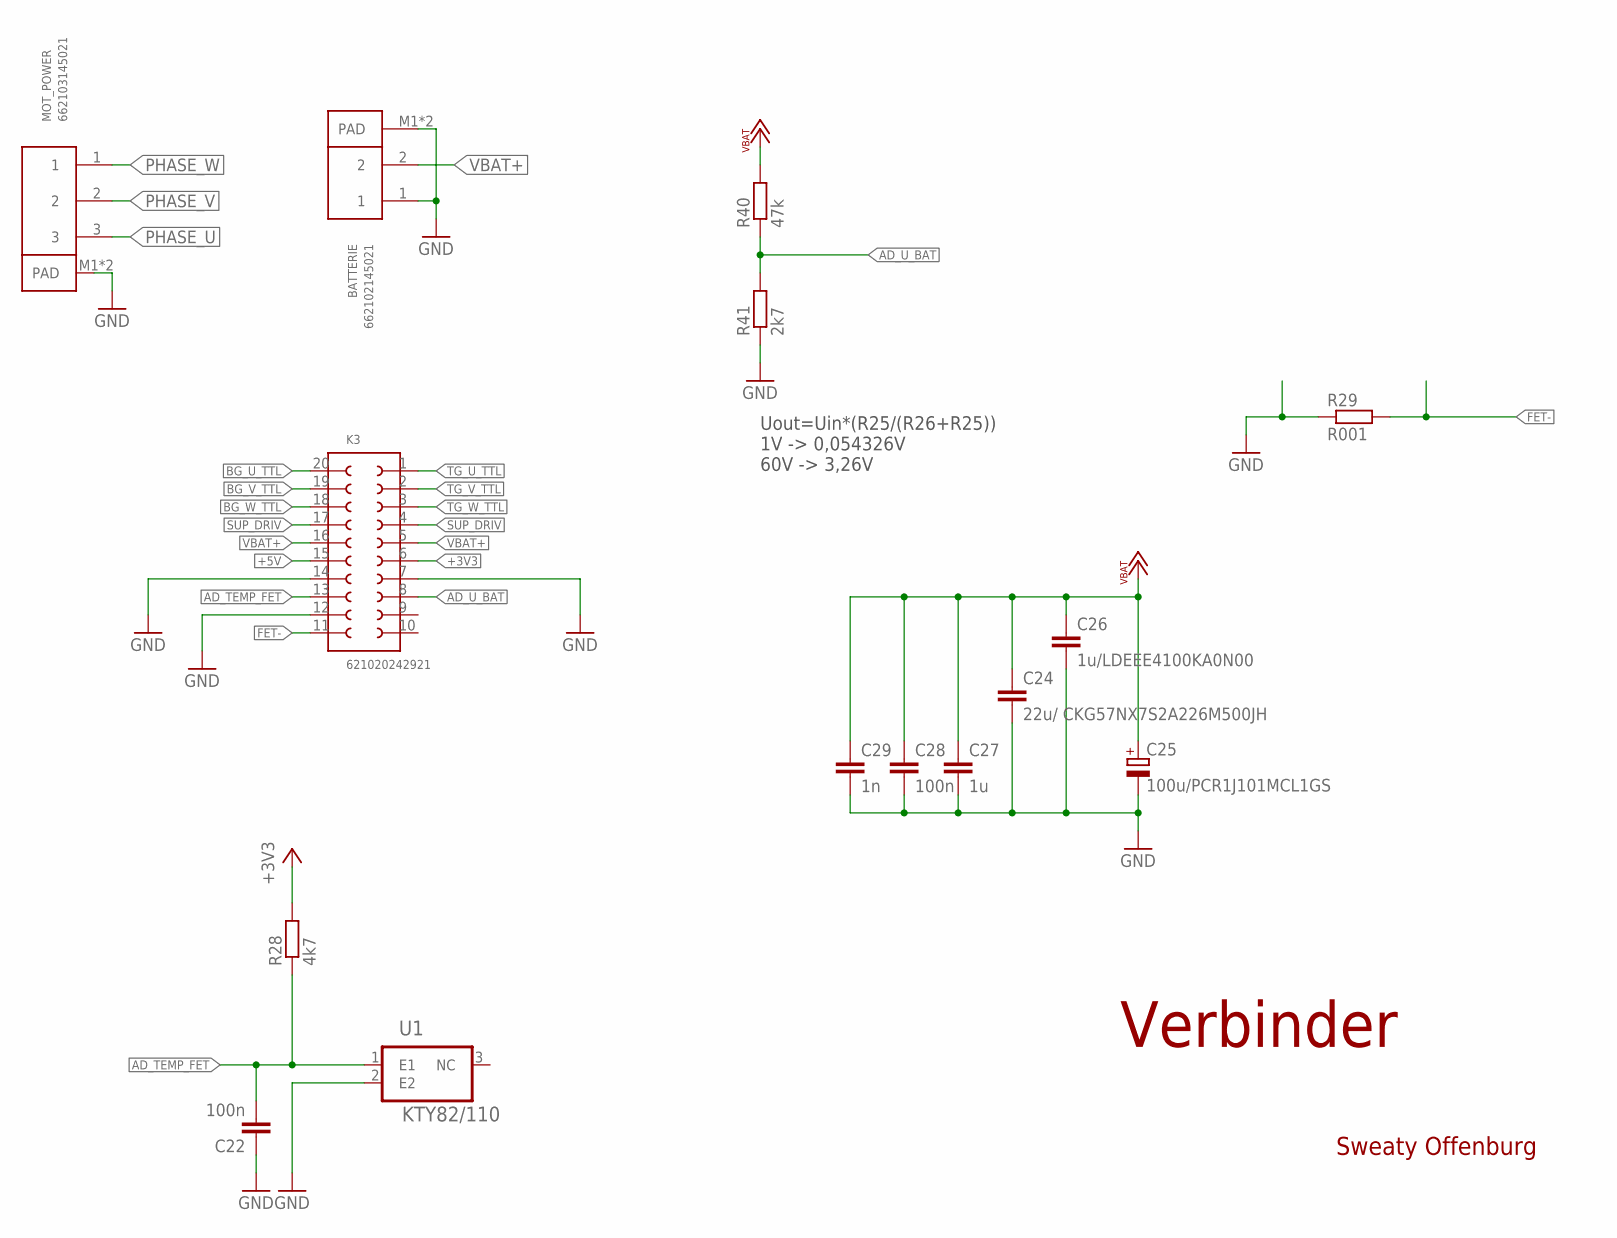
[picture p20: schematic Servo2015_Power_V1.2.sch, sheet 4]

Parts:
BATTERIE: 662102145021
C22, C28: 100n; C0603
C24: 22u/ CKG57NX7S2A226M500JH; CKG57-5750-CC2220
C25: 100u/PCR1J101MCL1GS; PANASONIC_G
C26: 1u/LDEEE4100KA0N00; C2824
C27: 1u; C1210
C29: 1n; C0603
K3: 621020242921
MOT_POWER: 662103145021
R28: 4k7; R0603
R29: R001; R2512
R40: 47k; R0603
R41: 2k7; R0603
U1: KTY82/110; SOT95P230X110-3N

Connections:
+3V3: K3.6, R28.2
+5V: K3.15
AD_TEMP_FET: C22.2, K3.13, R28.1, U1.1 (E1)
AD_U_BAT: K3.8, R40.1, R41.2
BG_U_TTL: K3.20; also elsewhere on the board
BG_V_TTL: K3.19; also elsewhere on the board
BG_W_TTL: K3.18; also elsewhere on the board
FET-: K3.11, R29.2; also elsewhere on the board
GND: BATTERIE.1, BATTERIE.M1 (PAD), BATTERIE.M2 (PAD), C22.1, C24.2, C25.-, C26.2, C27.2, C28.2, C29.2, K3.7, K3.12, K3.14, MOT_POWER.M1 (PAD), MOT_POWER.M2 (PAD), R29.1, R41.1, U1.2 (E2)
PHASE_U: MOT_POWER.3; also elsewhere on the board
PHASE_V: MOT_POWER.2; also elsewhere on the board
PHASE_W: MOT_POWER.1; also elsewhere on the board
SUP_DRIV: K3.4, K3.17; also elsewhere on the board
TG_U_TTL: K3.1; also elsewhere on the board
TG_V_TTL: K3.2; also elsewhere on the board
TG_W_TTL: K3.3; also elsewhere on the board
VBAT+: BATTERIE.2, C24.1, C25.+, C26.1, C27.1, C28.1, C29.1, K3.5, K3.16, R40.2; also elsewhere on the board

Notes on the sheet:
Verbinder
Uout=Uin*(R25/(R26+R25)) 1V -> 0,054326V 60V -> 3,26V
Sweaty Offenburg

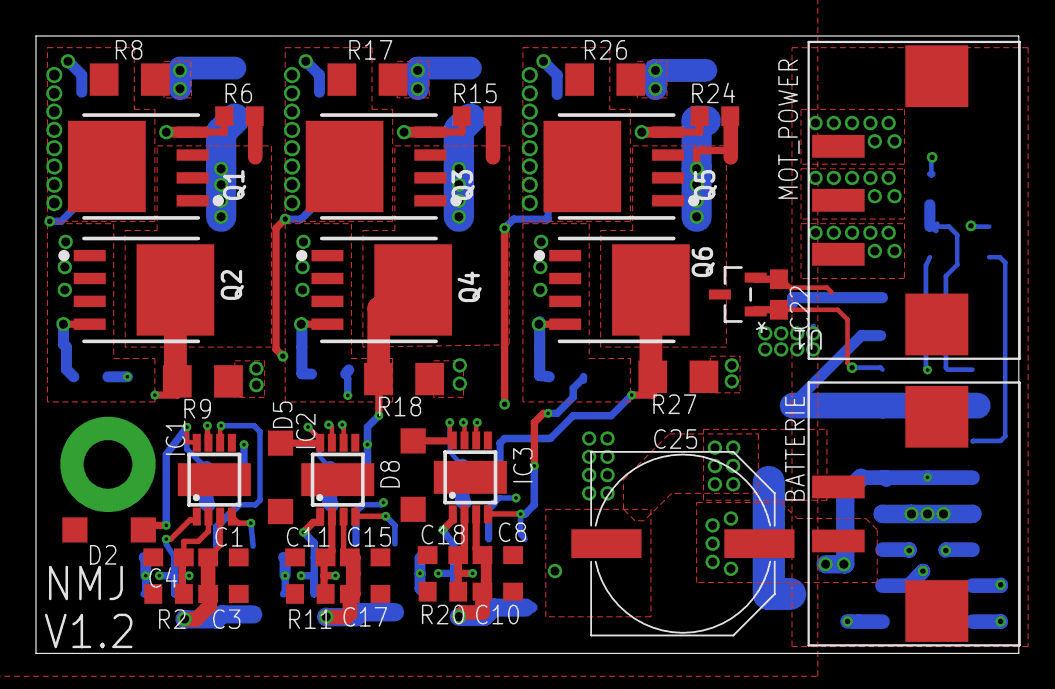
[picture p21: board Servo2015_Power_V1.2.brd from above]

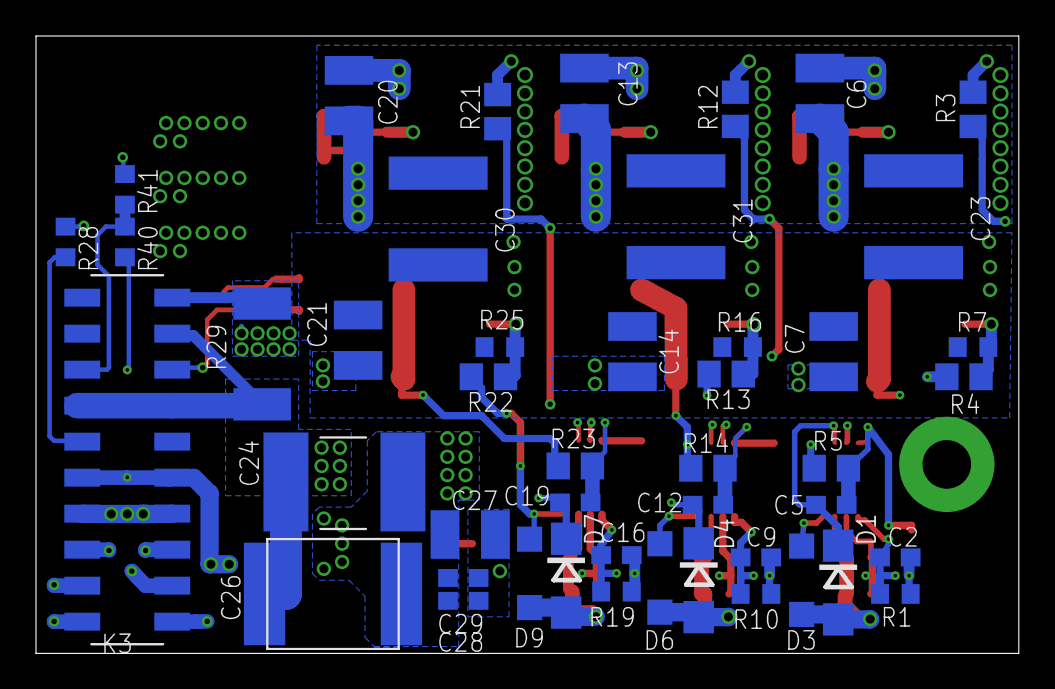
[picture p22: board Servo2015_Power_V1.2.brd from below]

Board: 4 copper layers, 54.6 x 34.3 mm, 85 parts (46 on the bottom side), 40 nets.

Other parts of the board:
U$1: A4L-LOC
